IWIN-FINS/FinsROV-Heavy/docs/reference/README.md

# Original reference attachments / 原始参考附件

[Build guide](../README.md) · [制作教程](../README.zh-CN.md)

These files were supplied with the V5 build notes and are retained byte-for-byte. They are reference copies, not newly maintained releases. Third-party software, manuals and embedded notices retain their original ownership and terms; the repository's root license does not relicense them. The executables were not run during documentation preparation.

以下文件随原制作记录提供，按原字节保存。第三方程序及厂商文档适用其原有声明，不因放入本仓库而改为根目录许可证。

| Attachment / 附件 | Use / 用途 |
| --- | --- |
| [BLHeliSuite32 32.10.0.0](BLHeliSuite32_32.10.0.0.zip?raw=true) | 原实装 BLHeli32 调参工具；先核对电调版本 |
| [PCM380 曲线拟合调试软件用户版 V0.1](PCM380曲线拟合调试软件用户版V0.1.rar?raw=true) | 原水压计调参工具；名称不用于改写实装传感器型号 |
| [水压计操作录像](<用户调试软件V0.1 2025-10-29 16-39-50.mp4?raw=true>) | 原记录的调参过程 |
| [达妙 DM-ORIN NX V2.X 说明书 V1.0](<达妙科技DM-ORIN NX V2.X使用说明书V1.0.pdf?raw=true>) | 载板接口和引脚参考；核对实物版本 |

The original interactive PCB BOM is under [hardware/pcb/assembly](../../hardware/pcb/assembly/README.md). The three Jetson script attachments have publication fixes and are under [software/jetson](../../software/jetson/README.md). See [sources and hashes](../SOURCES.md).
