IWIN-FINS/FinsROV-Heavy/hardware/bom/BOM-electronics.csv

物料编号 | 物料名称 | 单舱数量 | 单位 | 准备方式 | 型号、规格与尺寸 | 核对状态 | 采购或加工渠道 | 采购或加工链接 | 下单与装配说明 | CAD 实例名称 | STEP 产品定义 | 依据 | 参考资料链接
EC-01 | 运动控制主板 | 1 | 块 | 成品购买 | DJI RoboMaster 开发板 A 型 | 型号已识别 | DJI 商城 | https://store.dji.com/product/rm-development-board-type-a?from=shop | STM32F427IIH6；与机载计算机经 UART 通信。核所购套件配线及库存。 | ROBOMASTER_A板 v2 | #3176918 | STEP 实例；论文实机平台说明与硬件图 | https://www.robomaster.com/zh-CN/products/components/general/development-board
EC-02 | 机载计算载板 | 1 | 块 | 成品购买 | 达妙 DM Orin NX-CB-V2.1 | 版本待核 | 达妙原厂咨询 | https://www.dmbot.cn/index.php?c=show&id=97 | 按 V2.1 核对接口与孔位。套装如已含 EC-03 或散热件，应从分购清单扣除。 | DM Orin NX-CB-V2.1 v3 | #3177263 | 舱内装配.step 实例名与装配树
EC-03 | 机载计算模组 | 1 | 块 | 成品购买 | NVIDIA Jetson Orin NX；CAD 嵌套于达妙载板 | 容量待核 | NVIDIA 模组渠道 | https://www.nvidia.cn/autonomous-machines/embedded-systems/ | 单机 1 块。8 GB / 16 GB、启动存储配置与散热器供货范围待核；CAD 子树含风扇和散热件。 | JESTON ORIN NX核心板 v2 | #3178250 | STEP 实例；论文实机平台说明与硬件图 | https://www.nvidia.cn/autonomous-machines/embedded-systems/jetson-orin/
EC-04 | 惯性测量单元（IMU） | 1 | 处 | 成品购买 | 论文实机 WHEELTEC H30；CAD 为达妙 DM-IMU-L1 | 实机版本待核 | 淘宝检索论文型号 | https://s.taobao.com/search?q=%E8%BD%AE%E8%B6%A3%20H30%20IMU | 按一个安装位置计。论文图可见 WHEELTEC 字样；暂按实验用 H30 备查。购买前核版本、接口和安装孔。 | 达妙IMU v3 | #3177175 | STEP 实例；论文实机平台说明与硬件图 | https://wiki.seeedstudio.com/cn/wheeltec_imu/
EC-05 | 四合一无刷电调 | 2 | 块 | 成品购买 | 每块 4 路，安装孔距 30.5 mm；BLHeli_32，双向 DShot | 原购型号待核 | 淘宝按参数检索 | https://s.taobao.com/search | 2 块共驱动 8 台推进器。核品牌、额定电流、供电范围和双向转速回传支持；D13 是导入几何名称。 | 四合一电调30.5孔距 v2 | #3176903、#3176905 | STEP 实例；论文实机平台说明与硬件图
EC-06 | 电力线载波通信板（舱端） | 1 | 套 | 成品/板卡待核 | PCB 子装配含 MSE510CE_Rev.G 模块 | 整板料号待核 | 同类舱端模块询价 | https://fdocean.com/public/gjbj-35/162.html | 本行计舱端 1 套，含底板及子模块。原购型号、电源、接线及与岸端的配对方案待确认。 | 电力载波 v1 | #3176925 | STEP 实例；论文实机平台说明与硬件图
EC-07 | 电源保护与配电板 | 1 | 块 | PCB 制板及装联 | 基于 TI LM5069；CAD 板约 80 × 80 × 1.6 mm | R12 装配状态及板版待核 | 嘉立创 PCBA（推荐） | https://www.jlc-smt.com/ | 已附交互 BOM：R12=10kΩ/R0603/C25804，装配标记为真；原文写不焊且已修改，需核 Gerber/工程/HTML 同版。 | 电源板 v1 | #3177189 | 舱内 STEP；原焊接教程与交互 BOM 存在 R12 冲突 | https://github.com/IWIN-FINS/FinsROV-Heavy/blob/main/docs/build/03-power-board.zh-CN.md
EC-08 | 电调对插板（公板） | 1 | 块 | PCB 制板及装联 | 板约 80 × 40 × 1.6 mm；4 个 12P 连接器、8 个 MR30PB | 设计资料待补 | 嘉立创 PCBA（推荐） | https://www.jlc-smt.com/ | U1–U4 为 2.00 mm 间距连接器，CN1–CN8 为三芯电机接口。需板文件、针脚定义及装联资料。 | 电调对插板_公 v1 | #3176855 | 舱内装配.step 实例名与装配树 | https://www.china-amass.com/biao/632.html
EC-09 | 电调对插板（母板） | 1 | 块 | PCB 制板及装联 | 板约 93 × 74.5 × 1.6 mm；4 个 12P 连接器 | 设计资料待补 | 嘉立创 PCBA（推荐） | https://www.jlc-smt.com/ | 与 EC-08 配对。CAD 型号 XDCZ-20F1-12P，需确认插合面方向、针脚定义及制造资料。 | 电调对插板_母 v2 | #3176883 | 舱内装配.step 实例名与装配树
EC-10 | 20 位接线端子排 | 1 | 条 | 成品购买 | H3800-20P；CAD 长约 80 mm | 按极数选型 | 联捷 H3800 系列 | https://www.cnelinker.com/product.php?goods_id=1258&x=y | 按极数、接线方式、安装面及额定电流核完整订货号。 | H3800-20P v1 | #3176916 | 舱内装配.step 实例名与装配树
EC-11 | 18 位接线端子排 | 1 | 条 | 成品购买 | H3800-18P；CAD 长约 73 mm | 按极数选型 | 联捷 H3800 系列 | https://www.cnelinker.com/product.php?goods_id=1258&x=y | 按极数、接线方式、安装面及额定电流核完整订货号。 | H3800-18P v2 | #3178277 | 舱内装配.step 实例名与装配树
IF-01 | 1W 固定式水密插座 | 10 | 只 | 成品购买 | 1W_HVG；壳号与芯数组合待核 | 待选芯数 | LEMO 系列参考 | https://www.lemo.com/int_zh/solutions/supreme/w-underwater.html | 电机端 8、信号端 2，共 10 只。另有本体 EL-02 在电池舱前盖，按两份 CAD 合计 11 只。 核原厂、芯数、键位、额定水深、配插头和锁紧附件。 | 1W_HVG固定式插座 v2 | #3178267 | 舱内装配.step；主体装配.step 设备所在舱盖
IF-02 | 00W 固定式水密插座 | 10 | 只 | 成品购买 | 00W_HVG；壳号与芯数组合待核 | 待选芯数 | LEMO 系列参考 | https://www.lemo.com/int_zh/solutions/supreme/w-underwater.html | 10 只均在信号端。 核原厂、芯数、键位、额定水深、配插头和锁紧附件。 | 00W_HVG固定式插座 v2 | #3178273 | 舱内装配.step；主体装配.step 设备所在舱盖
IF-03 | 水下两段式开关 | 1 | 只 | 成品购买 | ELEC-M10x1XNKG0203；M10 × 1 | 原购型号待核 | 同规格开关参考 | https://sublab.info/communication-control-power/switch | 本件在电子舱信号端。本体 EL-01 在电池舱，按两份 CAD 共 2 只。核实际品牌、触点及线束。 | 水下两段式开关 v2 | #3177182 | 舱内装配.step；主体装配.step 设备所在舱盖
IF-04 | M16 穿线螺丝 | 1 | 件 | 成品选配 | MECH-PB16-1；配 M16 × 1.5 螺母 | 供应商待核 | 淘宝按规格检索 | https://s.taobao.com/search | 与 IF-05 配套。核密封面、线径、耐压与灌封工艺；若成套供货含螺母，一套即可。 | M16穿线螺丝 v1 | #3178268 | 舱内装配.step 实例名与装配树
IF-05 | M16 穿线螺母 | 1 | 个 | 核随件后配购 | M16 × 1.5 | 随件待核 | 淘宝按规格检索 | https://s.taobao.com/search | CAD 单列 1 个。先核 IF-04 装箱清单，再定是否单买。 | M16穿线螺母 v1 | #3178269 | 舱内装配.step 实例名与装配树
IF-06 | 穿线格兰头 | 1 | 套 | 成品选配 | 外螺纹函料装配；CAD 含 2 个子件 | 尺寸待核 | SUBLAB 同类件参考 | https://sublab.info/cables-penetrators-connectors/glandpenetrator | 按整套购买。核实螺纹、线缆外径、护套和耐压要求；与本体 HW-03 盘点时合并。 | 穿线格兰头 v1 | #3178274 | 舱内装配.step 实例名与装配树
IF-07 | 1W 插座固定件 | 1 | 件 | 核随件后配购 | 1W_HVG固定螺丝；CAD 已建模 1 件 | 实际用量待核 | 插座厂家配套询价 | https://www.lemo.com/int_zh/solutions/supreme/w-underwater.html | 模型为薄型锁紧件。数量仅代表可见实例，按各插座实际安装及随附锁紧件核齐，避免按插座数或按此数直接采购。 | 1W_HVG固定螺丝 v2 | #3177187 | 舱内装配.step 实例名与装配树
IF-08 | 00W 插座固定件 | 7 | 件 | 核随件后配购 | 00W_HVG固定螺丝；CAD 已建模 7 件 | 实际用量待核 | 插座厂家配套询价 | https://www.lemo.com/int_zh/solutions/supreme/w-underwater.html | 模型为薄型锁紧件。数量仅代表可见实例，按各插座实际安装及随附锁紧件核齐，避免按插座数或按此数直接采购。 | 00W_HVG固定螺丝 v1 | #3177186、#3177185、#3178265、#3178266、#3178270、#3178271 | 舱内装配.step 实例名与装配树
MTI-01 | 法兰舱内固定环 | 1 | 件 | FDM 3D 打印 | 适配 115 法兰；CAD 轴向跨度约 21 mm | 工艺已确认，耗材待补 | 嘉立创 FDM（推荐） | https://www.jlc-3dp.cn/benefit | 每舱 1 件，单件见制造索引 MTI-01。作者确认 FDM；耗材、打印方向、层高、壁厚、填充及配合待补。 | 法兰仓内固定环 v3 | #3176844 | 作者确认舱内安装件均为 FDM；STEP 实例与单件几何 | https://github.com/IWIN-FINS/FinsROV-Heavy/blob/main/hardware/mechanical/README.zh-CN.md
MTI-02 | 对插板固定件 | 1 | 件 | FDM 3D 打印 | CAD 顶点跨度约 94.6 × 69.9 × 18 mm | 工艺已确认，耗材待补 | 嘉立创 FDM（推荐） | https://www.jlc-3dp.cn/benefit | 每舱 1 件，单件见制造索引 MTI-02。作者确认 FDM；耗材、打印方向、层高、壁厚、填充及配合待补。 | 对插板固定件 | #3176901 | 作者确认舱内安装件均为 FDM；STEP 实例与单件几何 | https://github.com/IWIN-FINS/FinsROV-Heavy/blob/main/hardware/mechanical/README.zh-CN.md
MTI-03 | 主控固定板 | 1 | 件 | FDM 3D 打印 | 底板子件，约 115 × 86 × 5 mm | 工艺已确认，耗材待补 | 嘉立创 FDM（推荐） | https://www.jlc-3dp.cn/benefit | 每舱 1 件，单件见制造索引 MTI-03。作者确认 FDM；耗材、打印方向、层高、壁厚、填充及配合待补。 | 主控固定板 | #3176909 | 作者确认舱内安装件均为 FDM；STEP 实例与单件几何 | https://github.com/IWIN-FINS/FinsROV-Heavy/blob/main/hardware/mechanical/README.zh-CN.md
MTI-04 | 电调固定板 | 1 | 件 | FDM 3D 打印 | 底板子件，约 113 × 86 × 6 mm | 工艺已确认，耗材待补 | 嘉立创 FDM（推荐） | https://www.jlc-3dp.cn/benefit | 每舱 1 件，单件见制造索引 MTI-04。作者确认 FDM；耗材、打印方向、层高、壁厚、填充及配合待补。 | 电调固定板 | #3176910 | 作者确认舱内安装件均为 FDM；STEP 实例与单件几何 | https://github.com/IWIN-FINS/FinsROV-Heavy/blob/main/hardware/mechanical/README.zh-CN.md
MTI-05 | 上板 | 1 | 件 | FDM 3D 打印 | 约 122.7 × 86 × 3 mm | 工艺已确认，耗材待补 | 嘉立创 FDM（推荐） | https://www.jlc-3dp.cn/benefit | 每舱 1 件，单件见制造索引 MTI-05。作者确认 FDM；耗材、打印方向、层高、壁厚、填充及配合待补。 | 上板 | #3177179 | 作者确认舱内安装件均为 FDM；STEP 实例与单件几何 | https://github.com/IWIN-FINS/FinsROV-Heavy/blob/main/hardware/mechanical/README.zh-CN.md
MTI-06 | Orin NX 固定板 | 1 | 件 | FDM 3D 打印 | v2；约 106.8 × 90 × 6 mm | 工艺已确认，耗材待补 | 嘉立创 FDM（推荐） | https://www.jlc-3dp.cn/benefit | 每舱 1 件，单件见制造索引 MTI-06。作者确认 FDM；耗材、打印方向、层高、壁厚、填充及配合待补。 | ORIN NX固定板 v2 | #3178263 | 作者确认舱内安装件均为 FDM；STEP 实例与单件几何 | https://github.com/IWIN-FINS/FinsROV-Heavy/blob/main/hardware/mechanical/README.zh-CN.md
MTI-07 | 电源底板 | 1 | 件 | FDM 3D 打印 | 约 86 × 78 × 8 mm | 工艺已确认，耗材待补 | 嘉立创 FDM（推荐） | https://www.jlc-3dp.cn/benefit | 每舱 1 件，单件见制造索引 MTI-07。作者确认 FDM；耗材、打印方向、层高、壁厚、填充及配合待补。 | 电源底板 | #3178264 | 作者确认舱内安装件均为 FDM；STEP 实例与单件几何 | https://github.com/IWIN-FINS/FinsROV-Heavy/blob/main/hardware/mechanical/README.zh-CN.md
MTI-08 | 定长螺母条 | 4 | 根 | 定长采购 / 加工 | CAD 337 × 6 × 2 mm；单舱四根 | 螺纹规格待核 | 按尺寸检索 | https://s.taobao.com/search | 需材质、孔距、牙规与端部孔中心位置。 | 螺母条_定制长度款 v1 | #3176849 | 舱内装配.step 实例名与装配树
FI-01 | M3 铝柱 45 mm | 6 | 根 | 标准件购买 | M3，长 45 mm；铝 | 按尺寸选型 | 淘宝按规格检索 | https://s.taobao.com/search?q=M3%20%E9%93%9D%E6%9F%B1%2045%20mm%20M3 | 核对端部形式、螺纹有效长度及截面尺寸后选型。 | M3铝柱*45 v2 | #3176845、#3176846、#3176847、#3176848、#3176850、#3176851 | 舱内装配.step 实例名与装配树
FI-02 | M3 单头不锈钢柱 20 mm | 6 | 根 | 标准件购买 | M3 × 20 mm，单头牙 | 按尺寸选型 | 淘宝按规格检索 | https://s.taobao.com/search | 核对端部形式、螺纹有效长度及截面尺寸后选型。 | M3*20单头牙不锈钢柱 v2 | #3176894、#3176895、#3176896、#3176897、#3176898、#3176899 | 舱内装配.step 实例名与装配树
FI-03 | M3 铝柱 20 mm | 4 | 根 | 标准件购买 | M3，长 20 mm；铝 | 按尺寸选型 | 淘宝按规格检索 | https://s.taobao.com/search?q=M3%20%E9%93%9D%E6%9F%B1%2020%20mm%20M3 | 核对端部形式、螺纹有效长度及截面尺寸后选型。 | M3铝柱_20mm v1 | #3176920、#3176921、#3176922、#3176923 | 舱内装配.step 实例名与装配树
FI-04 | M3 单头不锈钢柱 10 mm | 4 | 根 | 标准件购买 | M3 × 10 mm，单头牙 | 按尺寸选型 | 淘宝按规格检索 | https://s.taobao.com/search | 核对端部形式、螺纹有效长度及截面尺寸后选型。 | 单头牙M3*10不锈钢柱 v1 | #3177261 | 舱内装配.step 实例名与装配树
FI-05 | M3 扁平头螺丝 | 8 | 颗 | 标准件购买 | M3 × 5 mm，扁平头 | 按尺寸选型 | 淘宝按规格检索 | https://s.taobao.com/search | 核头径、头厚、槽型和材质，与安装板间隙匹配。 | M3*5扁平头螺丝 v2 | #3176902、#3176911、#3176912、#3176913、#3176914 | 舱内装配.step 实例名与装配树
REF-01 | 亚克力舱管 | 1 | 根 | 本体 BOM 已计 | SUBLAB 14010204-1155；115 × 400 mm | 沿用本体物料 | 本体 BOM · EN-01 | https://shop384160755.taobao.com/ | 单舱数量供装配核对，已包含在本体 BOM 对应行，整机汇总时跳过。 | 115*400亚克力舱体 v1 | #3176854 | 舱内装配.step；主体装配.step 设备所在舱盖
REF-02 | 115 法兰 | 2 | 套 | 本体 BOM 已计 | SUBLAB 14010401-1151；本舱占全机 4 套中的 2 套 | 沿用本体物料 | 本体 BOM · EN-03 | https://shop384160755.taobao.com/ | 单舱数量供装配核对，已包含在本体 BOM 对应行，整机汇总时跳过。 | 115法兰 v2 | #3176853 | 舱内装配.step；主体装配.step 设备所在舱盖
REF-03 | 电机端舱盖 | 1 | 件 | 本体 BOM 已计 | 铝合金 CNC；电机端 | 沿用本体物料 | 本体 BOM · EN-07 | https://www.jlc-cnc.com/ | 单舱数量供装配核对，已包含在本体 BOM 对应行，整机汇总时跳过。 | 舱盖_电机端 | #3177180 | 舱内装配.step；主体装配.step 设备所在舱盖
REF-04 | 信号端舱盖 | 1 | 件 | 本体 BOM 已计 | 铝合金 CNC；信号端 | 沿用本体物料 | 本体 BOM · EN-08 | https://www.jlc-cnc.com/ | 单舱数量供装配核对，已包含在本体 BOM 对应行，整机汇总时跳过。 | 舱盖_信号端 | #3177181 | 舱内装配.step；主体装配.step 设备所在舱盖
MTI-09 | IMU 保护外壳（选装） |  | 套 | FDM 3D 打印 | 遮护 IMU 电路，避免电路外露；模型含两片壳体 | 选装，不计默认数量 | 嘉立创 FDM（推荐） | https://www.jlc-3dp.cn/benefit | 选装时 1 套。核 IMU 型号、外壳安装空间、耗材及打印参数；用于电路遮护，不作为防水耐压壳。 | IMU外壳 v5 |  | 作者确认选装用途、舱内安装件为 FDM；独立模型 | https://github.com/IWIN-FINS/FinsROV-Heavy/blob/main/hardware/mechanical/README.zh-CN.md
