IWIN-FINS/FinsROV-Heavy/hardware/bom/BOM.csv

物料编号 | 物料名称 | 单机数量 | 单位 | 准备方式 | 型号、材料与尺寸 | 下单状态 | 采购渠道或推荐平台 | 采购或加工链接 | 随件说明与待核参数 | CAD 名称 | STEP 定义编号 | 判定依据 | 原厂规格或工艺说明链接
PR-01 | 水下推进器 | 8 | 台 | 成品购买 | HYDROCEAN MOT-P75-170；4 水平 + 4 垂直；4 CW + 4 CCW | 按料号采购 | 大洋智能原厂询价 | https://www.hydrocean.cn/underwater-thruster-p-75.html | 选择 170 版本；按编号图核对桨向与实际转向，确认网罩和线缆端接。 | P75推进器简图 | #159701 | 论文与 STEP；原制作记录确认 4 CW + 4 CCW | https://github.com/IWIN-FINS/FinsROV-Heavy/blob/main/docs/build/04-thrusters.zh-CN.md
EN-01 | 透明亚克力舱管 | 1 | 根 | 成品购买 | SUBLAB 14010204-1155；115 系列，长 400 mm | 按料号采购 | SUBLAB 官方淘宝店 | https://shop384160755.taobao.com/ | 按料号向官方店订购。 | 14010204-1155 | #159705 | CAD 料号与原厂规格一致 | https://sublab.info/enclosures-buoyancy-ballast/EnclosureAcrylicTube
EN-02 | 铝合金舱管 | 1 | 根 | 成品购买 | SUBLAB 14010301-1154；115 系列，长 350 mm | 按料号采购 | SUBLAB 官方淘宝店 | https://shop384160755.taobao.com/ | 按料号向官方店订购。 | 14010301-1154 | #159721 | CAD 料号与原厂规格一致 | https://sublab.info/enclosures-buoyancy-ballast/AlEnclosure
EN-03 | 密封舱法兰套件 | 4 | 套 | 成品购买 | SUBLAB 14010401-1151；115 系列 | 按料号采购 | SUBLAB 官方淘宝店 | https://shop384160755.taobao.com/ | 每套含 1 个端面圈、2 个径向圈。全机随件合计 4 个端面圈、8 个径向圈，已计入这 4 套。 | 14010401-1151 | #159720 | CAD 料号与原厂规格一致 | https://sublab.info/enclosures-buoyancy-ballast/flange
EN-04 | 铝舱安装座（宽款） | 1 | 套 | 成品购买 | SUBLAB 14010601-0046；原厂标称宽 46 mm | 待核安装尺寸 | SUBLAB 官方淘宝店 | https://shop384160755.taobao.com/ | 每套含底座、2 个夹块、2 颗长螺丝。CAD 节点为单实体，轴向跨度 150 mm，订购前核对实物图纸、孔距及有无改件。 已提供单件模型，见制造索引 EN-04。 | 14010601-0046 | #159719 | CAD 料号与原厂规格一致 | https://sublab.info/enclosures-buoyancy-ballast/EnclosurePlate
EN-05 | 电池舱后盖 | 1 | 件 | 铝合金 CNC | 铝合金；CAD 外圆 Ø115 mm，厚 6 mm | 按图询价 | 嘉立创 CNC（推荐） | https://www.jlc-cnc.com/ | 按本件孔图单独报价。补铝材牌号、表处、法兰贴合面粗糙度与公差，核对安装孔及螺纹标注。 已提供单件模型，见制造索引 EN-05。 | 电池舱后盖 | #159722 | 实机作者确认；STEP 实例与几何 | https://github.com/IWIN-FINS/FinsROV-Heavy/blob/main/hardware/mechanical/README.zh-CN.md
EN-06 | 电池舱前盖 | 1 | 件 | 铝合金 CNC | 铝合金；CAD 外圆 Ø115 mm，厚 6 mm | 按图询价 | 嘉立创 CNC（推荐） | https://www.jlc-cnc.com/ | 按本件孔图单独报价。补铝材牌号、表处、法兰贴合面粗糙度与公差，核对安装孔及螺纹标注。 已提供单件模型，见制造索引 EN-06。 | 电池舱前盖 | #159730 | 实机作者确认；STEP 实例与几何 | https://github.com/IWIN-FINS/FinsROV-Heavy/blob/main/hardware/mechanical/README.zh-CN.md
EN-07 | 电机端舱盖 | 1 | 件 | 铝合金 CNC | 铝合金；CAD 外圆 Ø115 mm，厚 6 mm | 按图询价 | 嘉立创 CNC（推荐） | https://www.jlc-cnc.com/ | 按本件孔图单独报价。补铝材牌号、表处、法兰贴合面粗糙度与公差，核对安装孔及螺纹标注。 已提供单件模型，见制造索引 EN-07。 | 舱盖_电机端 | #159773 | 实机作者确认；STEP 实例与几何 | https://github.com/IWIN-FINS/FinsROV-Heavy/blob/main/hardware/mechanical/README.zh-CN.md
EN-08 | 信号端舱盖 | 1 | 件 | 铝合金 CNC | 铝合金；CAD 外圆 Ø115 mm，厚 6 mm | 按图询价 | 嘉立创 CNC（推荐） | https://www.jlc-cnc.com/ | 按本件孔图单独报价。补铝材牌号、表处、法兰贴合面粗糙度与公差，核对安装孔及螺纹标注。 已提供单件模型，见制造索引 EN-08。 | 舱盖_信号端 | #159774 | 实机作者确认；STEP 实例与几何 | https://github.com/IWIN-FINS/FinsROV-Heavy/blob/main/hardware/mechanical/README.zh-CN.md
FR-01 | 机架侧板 A | 1 | 件 | 铝合金钣金 | 铝合金钣金；黑色阳极氧化；700 × 295 × 6 mm | 两侧同件，合计 2 件 | 嘉立创钣金（推荐） | https://www.jlc-bj.com/ | 作者确认两侧相同，统一用侧板V2.step，各行 1 件、合计 2 件。旧总装差异保留追溯；铝材牌号、孔公差及旧图适配待核。 | 侧板-铝合金钣金 | #159702 | 作者确认两侧相同、铝合金钣金及黑色阳极氧化；保留原 STEP 定义追溯 | https://github.com/IWIN-FINS/FinsROV-Heavy/blob/main/hardware/mechanical/README.zh-CN.md
FR-02 | 机架侧板 B | 1 | 件 | 铝合金钣金 | 铝合金钣金；黑色阳极氧化；700 × 295 × 6 mm | 两侧同件，合计 2 件 | 嘉立创钣金（推荐） | https://www.jlc-bj.com/ | 作者确认两侧相同，统一用侧板V2.step，各行 1 件、合计 2 件。旧总装差异保留追溯；铝材牌号、孔公差及旧图适配待核。 | 侧板-铝合金钣金 (1) | #159704 | 作者确认两侧相同、铝合金钣金及黑色阳极氧化；保留原 STEP 定义追溯 | https://github.com/IWIN-FINS/FinsROV-Heavy/blob/main/hardware/mechanical/README.zh-CN.md
FR-03 | 机架顶板 | 1 | 件 | 铝合金钣金 | 铝合金钣金；黑色阳极氧化；成形约 700 × 500 × 30 mm，板厚 6 mm | 已对应模型，图纸待核 | 嘉立创钣金（推荐） | https://www.jlc-bj.com/ | 单件见顶板V2.step。铝材牌号、折弯内 R、成形公差与螺纹待补；旧 PDF 适配待核。 | 顶板-铝合金钣金 | #159703 | 作者确认铝合金钣金、黑色阳极氧化；STEP 几何 | https://github.com/IWIN-FINS/FinsROV-Heavy/blob/main/hardware/mechanical/README.zh-CN.md
FR-04 | 舱体不锈钢光轴 | 4 | 根 | 定长采购 | 实心圆轴 Ø8 × 412 mm，平端，无建模螺纹 | 按尺寸选配 | 嘉立创 FA 定长光轴 | https://www.jlcfa.com/product/B/B08/BACA?series=1 | 选不锈钢、两端无加工；核牌号、外径及长度公差。目录为推荐渠道。 | 舱体不锈钢光轴、舱体不锈钢光轴_1、舱体不锈钢光轴_2、舱体不锈钢光轴_3 | #159706、#159707、#159708、#159709 | STEP 名称与实体几何
FR-05 | 光轴夹 | 6 | 套 | 成品购买 | 适配 Ø8 mm 光轴；CAD 夹宽 10 mm，安装孔 Ø4.5 mm | 待选型 | 淘宝按尺寸检索 | https://s.taobao.com/search | 每套两件按一套采购。比对安装面、孔位和耐蚀材质；原购货号待补。 已附垫片模型供参考，不重复计数。 | 光轴夹、光轴夹_1、光轴夹_2、光轴夹_3、光轴夹_4、光轴夹_5 | #159711、#159712、#159713、#159714、#159715、#159716 | 实机作者确认；STEP 实例与几何 | https://github.com/IWIN-FINS/FinsROV-Heavy/blob/main/hardware/mechanical/README.zh-CN.md
FR-06 | 带螺纹铝合金角码 | 2 | 件 | 成品选配 | 20 × 20 × 10 mm，壁厚 4 mm；模型孔 Ø4 / Ø3.3 mm | 待选型 | 淘宝按尺寸检索 | https://s.taobao.com/search | 制作笔记列 20×20×10 mm、M4 角码 2 件；保留 CAD 孔径。核孔距、安装对应及原购型号。 | 带螺纹铝合金角码、带螺纹铝合金角码_1 | #159727、#159728 | STEP 实例；原制作记录尺寸与数量 | https://github.com/IWIN-FINS/FinsROV-Heavy/blob/main/docs/build/02-frame.zh-CN.md
FR-07 | 机架横梁 | 2 | 件 | 铝合金钣金 | 铝合金钣金；黑色阳极氧化；CAD 长 500 mm、截面外廓 50 × 40 mm；制作笔记板厚 6 mm | 单件与总装版本待核 | 嘉立创钣金（推荐） | https://www.jlc-bj.com/ | 两件钣金、黑色阳极氧化。单件/总装版本差异仍待核；制作笔记框架板厚 6 mm，补牌号、折弯与螺纹。 | 横梁 | #159753 | 作者确认材料、工艺及表面处理；STEP 实例与几何 | https://github.com/IWIN-FINS/FinsROV-Heavy/blob/main/docs/build/02-frame.zh-CN.md
BU-01 | 定制浮力块 | 2 | 件 | 浮力材料定制 | PVC 发泡；密度 0.25 g/cm³（250 kg/m³）；材料耐压深度 250 m；CAD 长 700 mm | 材料参数已确认 | 大洋智能按图加工（推荐） | https://www.hydrocean.cn/subsea-buoyancy-foam.html | 定制 2 件；250 m 仅材料参数。教程预埋孔 Ø6.5 mm、M4×10 螺母共 22 颗（HW-09）；先核外牙/孔配合。净浮力及封装待补。 | 浮力块 | #159763 | 作者确认 PVC 发泡、密度及材料耐压深度；STEP 实例 | https://github.com/IWIN-FINS/FinsROV-Heavy/blob/main/docs/build/02-frame.zh-CN.md
SE-01 | 水压计 | 4 | 只 | 成品购买 | 南京沃天 PCM300Y；实机压力采集总线 RS485 | 待补订货参数 | 南京沃天原厂询价 | https://www.wt-tech.com/products/qssylb5800.html | 两个支架组各装 2 只。向原厂核量程、压力基准、供电、信号输出及是否另需 RS485 转换、线长和出线方式。 | PCM300Y | #159739 | 论文实机平台说明；STEP 实例；CAD 标注 PCM300Y
SE-02 | 水下双目相机 | 1 | 台 | 成品购买 | SUBLAB 11020201-0001；USB 2.0 / UVC | 按料号采购 | SUBLAB 官方淘宝店 | https://shop384160755.taobao.com/ | 固定相机台内 1 台；原厂套装含 USB 测试接口。 | 11020201-0001 | #159766 | CAD 料号与原厂规格一致 | https://sublab.info/sensor-cameras/binocularcam
SE-03 | 水下照明灯 | 3 | 盏 | 成品购买 | CAD 灯头外圆 Ø30 mm，轴向跨度约 132 mm | 待选型 | SUBLAB 官方店（候选） | https://shop384160755.taobao.com/ | 原购型号暂缺。可询 SUBLAB 10030201-0001，确认夹持段外径、总长、供电、调光和出线后再订。 | 照明灯官网图、照明灯官网图_1 | #159738、#159767 | 两 CAD 定义几何相符；2 盏位于灯/水压计支架，1 盏位于相机台 | https://sublab.info/thrusters-actuators-lights/slight
MT-01 | 水压计固定块 A | 1 | 件 | FDM 3D 打印 | A 组仅装水压计 | 按图询价 | 嘉立创 FDM（推荐） | https://m-3dp.jlc.com/placeOrder | 按对应 CAD 实体打印。待补耗材牌号与打印参数，试装核对夹持配合。 已提供单件模型，见制造索引 MT-01。 | 二合一固定块(镜像) (1) | #159733 | 实机作者确认；STEP 实例与几何 | https://www.jlc-3dp.cn/benefit
MT-02 | 水压计固定块 A 镜像件 | 1 | 件 | FDM 3D 打印 | A 组仅装水压计 | 按图询价 | 嘉立创 FDM（推荐） | https://m-3dp.jlc.com/placeOrder | 按对应 CAD 实体打印。待补耗材牌号与打印参数，试装核对夹持配合。 已提供单件模型，见制造索引 MT-02。 | 二合一固定块(镜像) (1)(镜像) | #159734 | 实机作者确认；STEP 实例与几何 | https://www.jlc-3dp.cn/benefit
MT-03 | 灯与水压计固定块 B | 1 | 件 | FDM 3D 打印 | B 组安装灯与水压计 | 按图询价 | 嘉立创 FDM（推荐） | https://m-3dp.jlc.com/placeOrder | 按对应 CAD 实体打印。待补耗材牌号与打印参数，试装核对夹持配合。 已提供单件模型，见制造索引 MT-03。 | 二合一固定块 | #159736 | 实机作者确认；STEP 实例与几何 | https://www.jlc-3dp.cn/benefit
MT-04 | 灯与水压计固定块 B 镜像件 | 1 | 件 | FDM 3D 打印 | B 组安装灯与水压计 | 按图询价 | 嘉立创 FDM（推荐） | https://m-3dp.jlc.com/placeOrder | 按对应 CAD 实体打印。待补耗材牌号与打印参数，试装核对夹持配合。 已提供单件模型，见制造索引 MT-04。 | 二合一固定块(镜像) | #159737 | 实机作者确认；STEP 实例与几何 | https://www.jlc-3dp.cn/benefit
MT-05 | 相机台主体支架 | 1 | 件 | FDM 3D 打印 | 相机云台 v15 内，长向跨度 162 mm | 按图询价 | 嘉立创 FDM（推荐） | https://m-3dp.jlc.com/placeOrder | 已提供单件模型，见制造索引 MT-05。 打印材料、方向、壁厚与螺纹处理待核。 | 零部件16 | #159770 | 实机作者确认；STEP 实例与几何；部位按父装配识别 | https://www.jlc-3dp.cn/benefit
MT-06 | 相机台固定座 | 1 | 件 | FDM 3D 打印 | 固定相机台下的独立零件，外廓约 80 × 35 × 40 mm | 按图询价 | 嘉立创 FDM（推荐） | https://m-3dp.jlc.com/placeOrder | 已提供单件模型，见制造索引 MT-06。 打印材料、方向、壁厚与螺纹处理待核。 | 零部件25 | #159771 | 实机作者确认；STEP 实例与几何；部位按父装配识别 | https://www.jlc-3dp.cn/benefit
MT-07 | 相机台内薄环板 | 1 | 件 | 工艺待核 | 厚 2 mm，中央圆孔 Ø26 mm；位于相机云台 v15 | 待核工艺 | 嘉立创按图评估（备选） | https://www.jlc-bj.com/ | 作者确认相机支架整体采用 FDM；该薄环板的用途、是否随设备配套及制法仍待确认。 | 零部件2_3 | #159768 | STEP 名称与实体几何
EL-01 | M10 舱壁电气件 | 1 | 套 | 成品购买 | CAD 标识 ELEC-M10x1XNKG0203；M10 × 1 | 待核身份 | SUBLAB 同类件咨询（候选） | https://sublab.info/communication-control-power/switch | 外形及代号提示可能为旋钮开关。核对实物功能、档位、走线与原厂料号后再订；按两子件组成的一套计。 | ELEC-M10x1XNKG0203 | #159724 | STEP 名称与实体几何
EL-02 | 1W 系列固定式插座 | 1 | 只 | 成品购买 | CAD 标识 1W_HVG；轴向长 30 mm | 待选型 | LEMO W 系列询价（候选） | https://www.lemo.com/int_zh/solutions/supreme/w-underwater.html | HVG.1W 为候选系列。实机品牌、芯数、键位、尾端形式、配插端货号及耐压等级待核。 | 1W_HVG固定式插座 | #159772 | STEP 名称与实体几何
CB-01 | 电机线夹压片 | 2 | 件 | 工艺待核 | 41 × 15 × 2 mm，2 个 Ø3.3 mm 孔 | 待核工艺 | 嘉立创钣金（备选） | https://www.jlc-bj.com/ | 实机材料及制法暂缺。若为金属压片，核板材、孔距与表处后询价。 已提供单件模型，见制造索引 CB-01。 | 零部件4 | #159742 | STEP 名称与实体几何 | https://github.com/IWIN-FINS/FinsROV-Heavy/blob/main/hardware/mechanical/README.zh-CN.md
CB-02 | 电机线夹压片（镜像） | 2 | 件 | 工艺待核 | 41 × 15 × 2 mm，2 个 Ø3.3 mm 孔 | 待核工艺 | 嘉立创钣金（备选） | https://www.jlc-bj.com/ | 实机材料及制法暂缺。若为金属压片，核板材、孔距与表处后询价。 已提供单件模型，见制造索引 CB-02。 | 零部件4(镜像) | #159745 | STEP 名称与实体几何 | https://github.com/IWIN-FINS/FinsROV-Heavy/blob/main/hardware/mechanical/README.zh-CN.md
CB-03 | 电机线夹夹体 | 2 | 件 | 3D 打印（具体工艺待核） | 夹体厚 15 mm，多槽 | 模型与数量口径待核 | 嘉立创 FDM（备选） | https://m-3dp.jlc.com/placeOrder | 教程写每台电机 1 夹、共 8 个；本行保留 STEP 数量，与 CB-04/CB-03 夹体合计 4 件。模型及压板对应、打印工艺/耗材待核。 | 零部件3 | #159743 | STEP 实例；原制作记录写 3D 打印 8 个，尚未完成模型对应 | https://github.com/IWIN-FINS/FinsROV-Heavy/blob/main/docs/build/02-frame.zh-CN.md
CB-04 | 电机线夹夹体（镜像） | 2 | 件 | 3D 打印（具体工艺待核） | 夹体厚 15 mm，多槽 | 模型与数量口径待核 | 嘉立创 FDM（备选） | https://m-3dp.jlc.com/placeOrder | 教程写每台电机 1 夹、共 8 个；本行保留 STEP 数量，与 CB-04/CB-03 夹体合计 4 件。模型及压板对应、打印工艺/耗材待核。 | 零部件3(镜像) | #159744 | STEP 实例；原制作记录写 3D 打印 8 个，尚未完成模型对应 | https://github.com/IWIN-FINS/FinsROV-Heavy/blob/main/docs/build/02-frame.zh-CN.md
CB-05 | 普通线夹 | 6 | 件 | 工艺待核 | 夹宽 10 mm，槽半径 3.5 mm，安装孔 Ø3.3 mm | 待核工艺 | 嘉立创 FDM（备选） | https://m-3dp.jlc.com/placeOrder | 实机材料及制法暂缺。可询 FDM 打样，先校核持线槽、夹紧力和固定孔。 已提供单件模型，见制造索引 CB-05。 | 零部件1_4 | #159752 | STEP 名称与实体几何 | https://github.com/IWIN-FINS/FinsROV-Heavy/blob/main/hardware/mechanical/README.zh-CN.md
CB-06 | 云台线缆夹 1 号夹体 | 1 | 件 | 工艺待核 | 夹体厚 15 mm，按 1 号夹槽图 | 待核工艺 | 嘉立创 FDM（备选） | https://m-3dp.jlc.com/placeOrder | 实机材料及制法暂缺。可询 FDM 打样，先校核持线槽、夹紧力和固定孔。 已提供单件模型，见制造索引 CB-06。 | 零部件2_2 | #159756 | STEP 名称与实体几何 | https://github.com/IWIN-FINS/FinsROV-Heavy/blob/main/hardware/mechanical/README.zh-CN.md
CB-07 | 云台线缆夹 1 号压片 | 1 | 件 | 工艺待核 | 41 × 15 × 2 mm，按 1 号压片图 | 待核工艺 | 嘉立创钣金（备选） | https://www.jlc-bj.com/ | 实机材料及制法暂缺。若为金属压片，核板材、孔距与表处后询价。 已提供单件模型，见制造索引 CB-07。 | 零部件3_1 | #159757 | STEP 名称与实体几何 | https://github.com/IWIN-FINS/FinsROV-Heavy/blob/main/hardware/mechanical/README.zh-CN.md
CB-08 | 云台线缆夹 2 号夹体 | 1 | 件 | 工艺待核 | 夹体厚 15 mm，按 2 号夹槽图 | 待核工艺 | 嘉立创 FDM（备选） | https://m-3dp.jlc.com/placeOrder | 实机材料及制法暂缺。可询 FDM 打样，先校核持线槽、夹紧力和固定孔。 已提供单件模型，见制造索引 CB-08。 | 零部件3_2 | #159761 | STEP 名称与实体几何 | https://github.com/IWIN-FINS/FinsROV-Heavy/blob/main/hardware/mechanical/README.zh-CN.md
CB-09 | 云台线缆夹 2 号压片 | 1 | 件 | 工艺待核 | 41 × 15 × 2 mm，按 2 号压片图 | 待核工艺 | 嘉立创钣金（备选） | https://www.jlc-bj.com/ | 实机材料及制法暂缺。若为金属压片，核板材、孔距与表处后询价。 已提供单件模型，见制造索引 CB-09。 | 零部件4_1 | #159762 | STEP 名称与实体几何 | https://github.com/IWIN-FINS/FinsROV-Heavy/blob/main/hardware/mechanical/README.zh-CN.md
CK-01 | 顶层空节点 |  |  | 待核占位 | 顶层定位点约 (2, −47.47, 2) mm；仅坐标系 | 待核身份 |  |  | 模型有 1 个定位实例。核实装配历史或照片后决定是否对应实物，单机物料数量留空。 | 零部件18 | #159723 | STEP 引用 #474，无实体和子件
HW-01 | 其余机架及外装设备紧固件 |  | 颗 | 另购标准件 | 推进器安装界面 4 × M3/台；其他位置按装配孔图 | 待统计 | 嘉立创 FA 紧固件选型 | https://www.jlcfa.com/serial/2129403909149.html?codeModel=EDLA-S2 | 不含已单列的 HW-06～HW-09。其余按实装统计并扣除套件随件；配重 M4 螺钉长度、螺母/垫圈及数量待核。 |  |  | 原厂 P75 接口；STEP 未单列紧固件 | https://www.hydrocean.cn/underwater-thruster-p-75.html
HW-02 | 舱盖与法兰安装螺钉 |  | 颗 | 另购标准件 | 四处盖板分别对照法兰端面孔及盖板孔图 | 待统计 | 嘉立创 FA 紧固件选型 | https://www.jlcfa.com/serial/2129403909149.html?codeModel=EDLA-S2 | 与机架紧固件分开计。核螺纹、头型、有效旋入长度及实装数量；法兰随件密封圈已计入 EN-03。 |  |  | STEP 装配界面；SUBLAB 法兰装箱清单 | https://sublab.info/enclosures-buoyancy-ballast/flange
HW-03 | 穿舱密封件及线缆格兰头 |  | 件 | 按接口配购 | 按实际出线逐路匹配线径、安装孔和舱盖厚度 | 待统计 | SUBLAB 官方淘宝店 | https://shop384160755.taobao.com/ | 盘点推进器、灯、相机和水压计的端接。扣除已随设备供货的接头；示例 M10 格兰头需核插孔及耐压等级。 |  |  | 设备裸线版本与舱盖孔图；STEP 未给全套端接 | https://sublab.info/cables-penetrators-connectors/copperglandpenetrator
HW-04 | 未用穿舱孔堵头 |  | 件 | 按接口配购 | 按实装后剩余孔的牙型、孔径和密封方式选型 | 待统计 | SUBLAB 官方淘宝店 | https://shop384160755.taobao.com/ | 扣除已有设备占用孔及套件随件。按实际空孔数选购并核随附密封圈。 |  |  | 原厂堵头选型资料；实装孔位待核 | https://sublab.info/cables-penetrators-connectors/BlankPenetrators
HW-05 | 水密插座配插端及尾附件 |  | 套 | 按接口配购 | 对应 EL-02 的线缆端插头及所需尾附件 | 待统计 | LEMO W 系列询价（候选） | https://www.lemo.com/int_zh/solutions/supreme/w-underwater.html | 确认 EL-02 的厂家、芯数、键位、线缆外径及实机是否已有成缆，再订配插端。 |  |  | STEP 仅有固定式插座节点
BU-02 | 配平铅块 |  | 块 | 成品购买 | 200 g/块；经验用量 4–5 块，总质量约 0.8–1.0 kg | 按需购买 | 淘宝：作者提供商品 | https://item.taobao.com/item.htm?id=561262404205 | 未配重时浮力大于重力。经验 4–5 块；按实际载荷水中配平增减。M4 紧固件计入 HW-01，垫片见 BU-03。 |  |  | 作者提供购买链接、用途与经验用量；未计入基准 STEP | https://e.tb.cn/h.jRkXFiwiurdhOld?tk=7QlA6d6JviR
BU-03 | 铅块孔径适配垫片 |  | 件 | 定制件，工艺待核 | 缩减铅块孔径，适配 M4 安装螺钉 | 按配重配置 | 加工方式待核 |  | 数量随铅块孔数与安装方案确定。材质、制法及配合公差待补；STEP 与 F3D 均已提供。 | 铅块垫片 |  | 作者确认用途；独立模型，未计入基准 STEP | https://github.com/IWIN-FINS/FinsROV-Heavy/blob/main/hardware/mechanical/README.zh-CN.md
MT-08 | 电池固定环 |  | 件 | FDM 3D 打印 | 电池支撑件，防止电池晃动和旋转 | 数量待核 | 嘉立创 FDM（推荐） | https://www.jlc-3dp.cn/benefit | 随实际电池外形配置，与定位片配合。材料、打印参数、数量及装配位置待补。 | 电池固定环 |  | 作者确认电池支撑为 3D 打印、舱内安装件为 FDM；独立模型 | https://github.com/IWIN-FINS/FinsROV-Heavy/blob/main/hardware/mechanical/README.zh-CN.md
MT-09 | 电池定位片 |  | 件 | FDM 3D 打印 | 电池支撑件，防止电池晃动和旋转 | 数量待核 | 嘉立创 FDM（推荐） | https://www.jlc-3dp.cn/benefit | 随实际电池外形配置，与固定环配合。材料、打印参数、数量及装配位置待补。 | 电池定位片 |  | 作者确认电池支撑为 3D 打印、舱内安装件为 FDM；独立模型 | https://github.com/IWIN-FINS/FinsROV-Heavy/blob/main/hardware/mechanical/README.zh-CN.md
MT-10 | 电池舱法兰填充件 |  | 件 | FDM 3D 打印 | 电池舱内部填充件；安装关系待核 | 数量及装配待核 | 嘉立创 FDM（推荐） | https://www.jlc-3dp.cn/benefit | 按舱内安装件 FDM 归类。与电池支撑的具体装配关系、实装数量及打印参数待补。 | 电池舱法兰填充 |  | 作者确认舱内安装件为 FDM；独立模型，具体装配关系待核 | https://github.com/IWIN-FINS/FinsROV-Heavy/blob/main/hardware/mechanical/README.zh-CN.md
CB-10 | 光轴短套管 |  | 件 | 工艺待核 | 用于限制线缆夹沿光轴平移 | 数量及制法待核 | 待核 |  | 按线夹位置配置；短/长套管数量、材质、制法及轴向间隙待补。 | 光轴短套管 |  | 作者确认限位用途；独立模型，未计入基准 STEP | https://github.com/IWIN-FINS/FinsROV-Heavy/blob/main/hardware/mechanical/README.zh-CN.md
CB-11 | 光轴长套管 |  | 件 | 工艺待核 | 用于限制线缆夹沿光轴平移 | 数量及制法待核 | 待核 |  | 按线夹位置配置；短/长套管数量、材质、制法及轴向间隙待补。 | 光轴长套管 |  | 作者确认限位用途；独立模型，未计入基准 STEP | https://github.com/IWIN-FINS/FinsROV-Heavy/blob/main/hardware/mechanical/README.zh-CN.md
HW-06 | 框架连接螺钉 | 42 | 颗 | 成品购买 | M4×12；不锈钢；内六角杯头 | 规格已知，原购型号待补 | 淘宝规格检索（非实购店） | https://s.taobao.com/search?q=M4x12%20%E6%9D%AF%E5%A4%B4 | 横梁 16 + 顶板 26 = 42 颗。旧版一孔偏小，先核最终孔/螺纹。数量为安装用量，采购扣除随件。 |  |  | 原制作记录：主体框架搭建；非 STEP 新增实例 | https://github.com/IWIN-FINS/FinsROV-Heavy/blob/main/docs/build/02-frame.zh-CN.md
HW-07 | 电池滑座安装沉头螺钉 | 10 | 颗 | 成品购买 | M3×10；不锈钢；沉头 | 规格已知，原购型号待补 | 淘宝规格检索（非实购店） | https://s.taobao.com/search?q=M3x10%20%E6%B2%89%E5%A4%B4 | 原教程滑座/角码安装步骤用量；采购前核实际孔位、沉头角度和随件，避免重复计数。 |  |  | 原制作记录：主体框架搭建；非 STEP 新增实例 | https://github.com/IWIN-FINS/FinsROV-Heavy/blob/main/docs/build/02-frame.zh-CN.md
HW-08 | 电池限位角码安装螺钉 | 2 | 颗 | 成品购买 | M4×10；不锈钢；内六角杯头 | 规格已知，原购型号待补 | 淘宝规格检索（非实购店） | https://s.taobao.com/search?q=M4x10%20%E6%9D%AF%E5%A4%B4 | 原教程滑座/角码步骤用量；角码最终定位照片待补，采购扣除随件。 |  |  | 原制作记录：主体框架搭建；非 STEP 新增实例 | https://github.com/IWIN-FINS/FinsROV-Heavy/blob/main/docs/build/02-frame.zh-CN.md
HW-09 | 浮力块预埋螺母 | 22 | 颗 | 成品购买 | M4×10；不锈钢；内外牙沉头 | 规格已知，原购型号待补 | 淘宝规格检索（非实购店） | https://s.taobao.com/search?q=M4x10%20%E9%A2%84%E5%9F%8B%E8%9E%BA%E6%AF%8D | 两块浮力块合计 22 颗；原记录安装孔 Ø6.5 mm，核所购外牙尺寸；端面低于浮力块接触面。 |  |  | 原制作记录：主体框架搭建；非 STEP 新增实例 | https://github.com/IWIN-FINS/FinsROV-Heavy/blob/main/docs/build/02-frame.zh-CN.md
