IWIN-FINS/FinsROV-Heavy/hardware/mechanical/source/框架/顶板.step

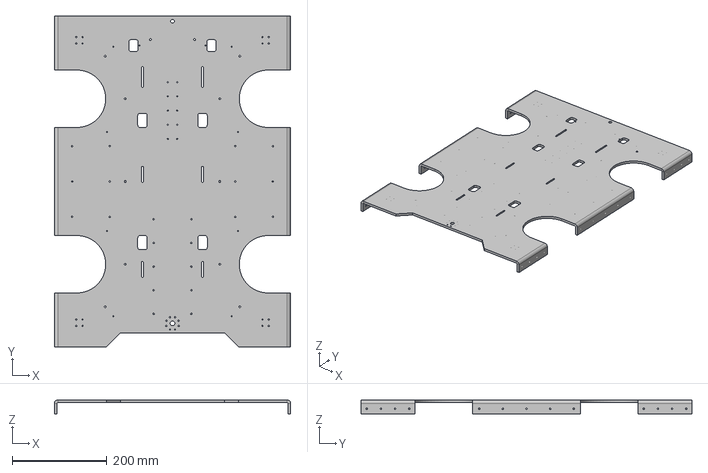
[picture p7: CAD file, 2026-11-11]
hardware/mechanical/source/框架/顶板.step
500.0 x 700.0 x 30.0 mm
