IWIN-FINS/FinsROV-Heavy/hardware/mechanical/source/框架V2/阿卡插座V2.step

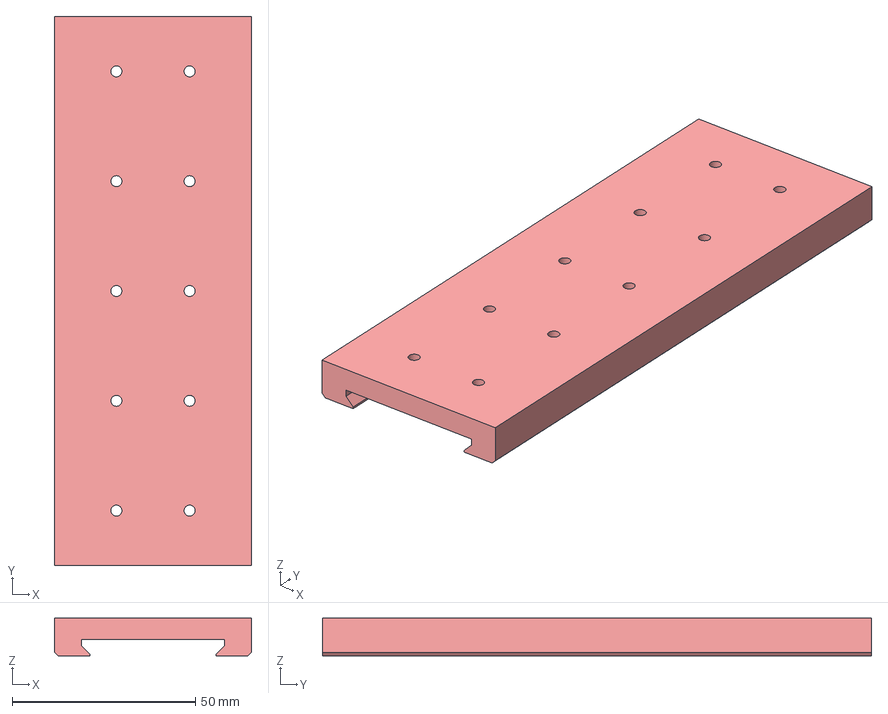
[picture p8: CAD file, 2026-11-11]
hardware/mechanical/source/框架V2/阿卡插座V2.step
53.9 x 150.0 x 10.3 mm
