IWIN-FINS/FinsROV-Heavy/hardware/mechanical/source/电池舱/电池固定环.step

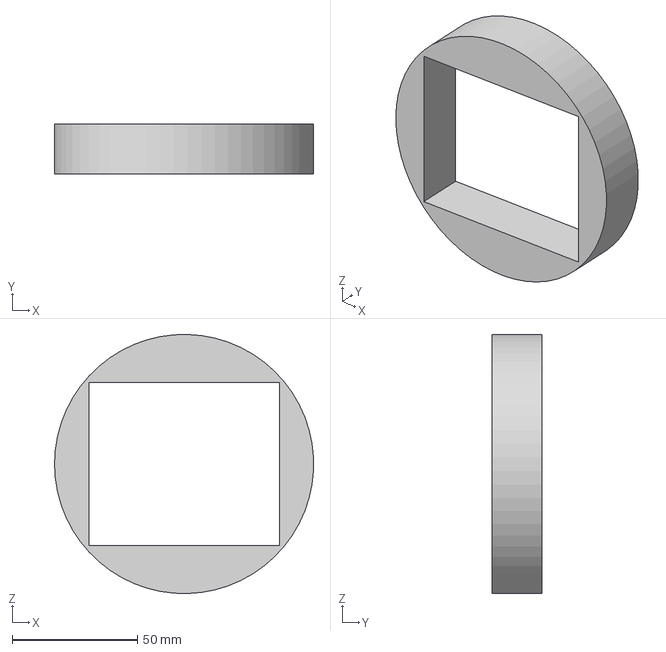
[picture p9: CAD file, 2026-11-11]
hardware/mechanical/source/电池舱/电池固定环.step
103.4 x 20.0 x 103.5 mm
