IWIN-FINS/FinsROV-Heavy/hardware/mechanical/source/盖子.step

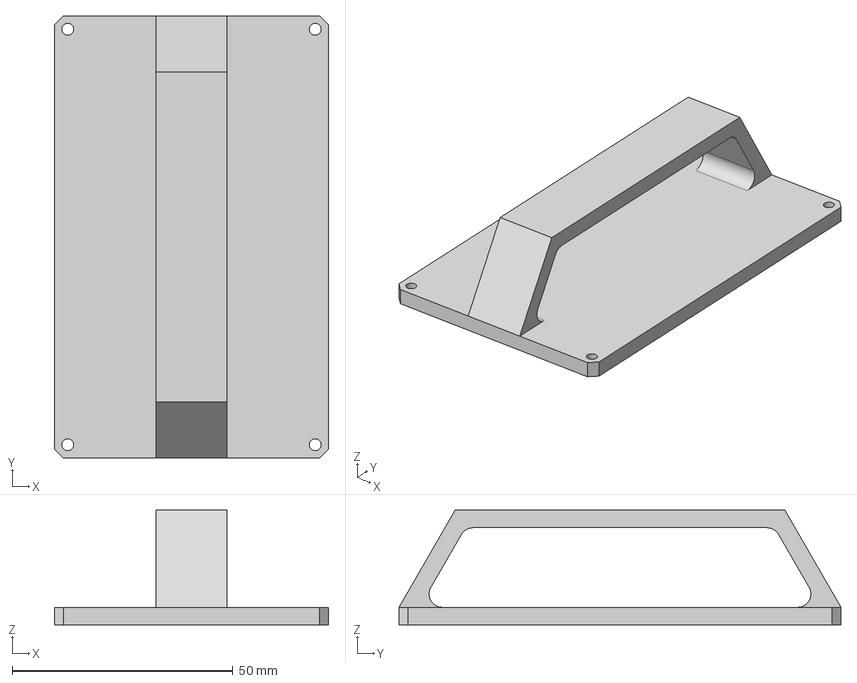
[picture p10: CAD file, 2026-11-11]
hardware/mechanical/source/盖子.step
62.0 x 100.0 x 26.0 mm
