IWIN-FINS/FinsROV-Heavy/hardware/mechanical/source/线缆夹/3pin细线缆管.step

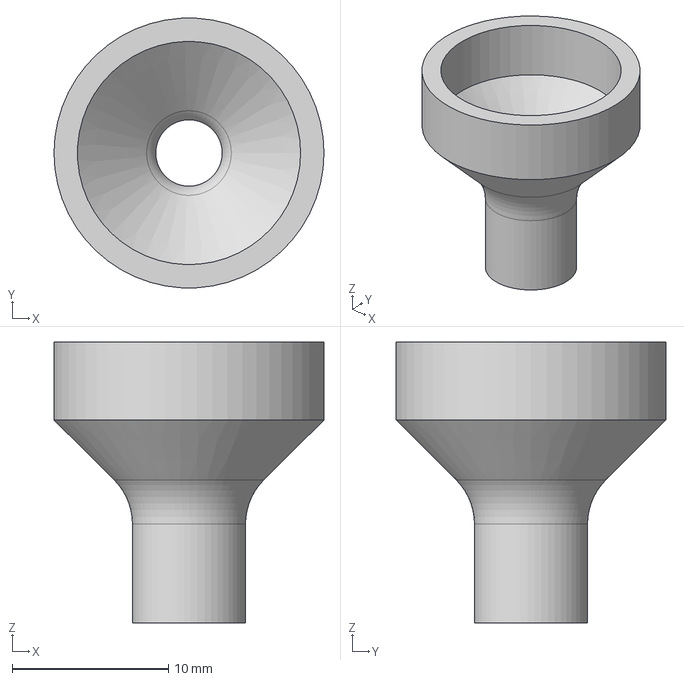
[picture p11: CAD file, 2026-11-11]
hardware/mechanical/source/线缆夹/3pin细线缆管.step
17.3 x 17.3 x 18.0 mm
