IWIN-FINS/FinsROV-Heavy/hardware/mechanical/source/设备舱/舱内/3mf格式/电源底板.3mf

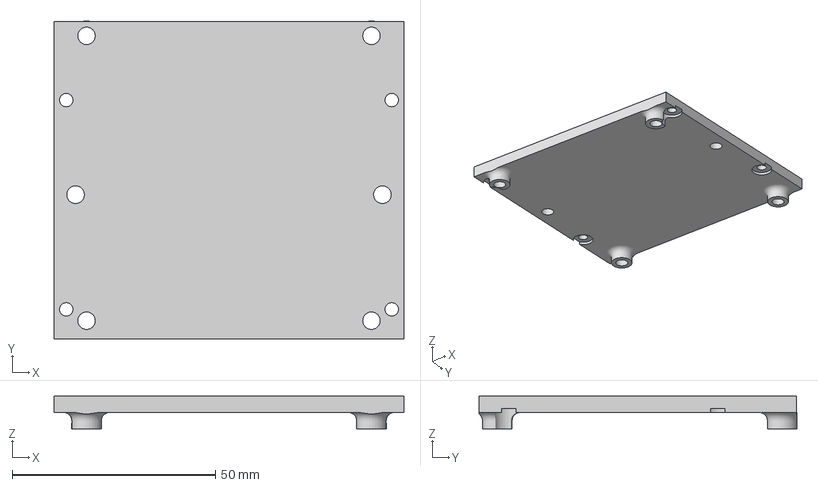
[picture p12: CAD file, 2026-11-11]
hardware/mechanical/source/设备舱/舱内/3mf格式/电源底板.3mf
86.0 x 78.2 x 8.00 mm
