IWIN-FINS/FinsROV-Heavy/hardware/mechanical/source/设备舱/舱内/ORIN NX固定板.step

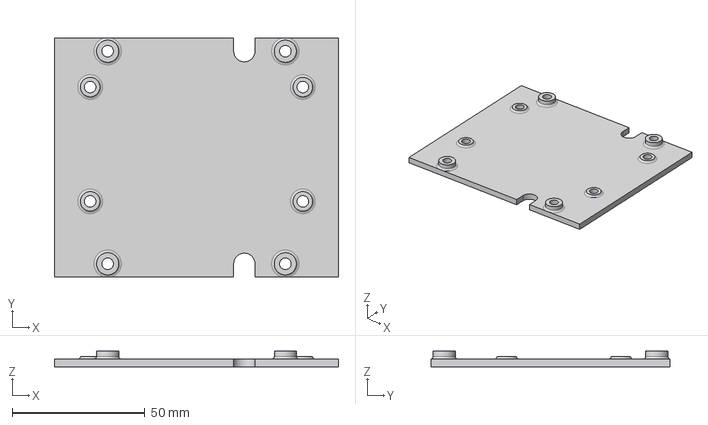
[picture p13: CAD file, 2026-11-11]
hardware/mechanical/source/设备舱/舱内/ORIN NX固定板.step
106.8 x 90.0 x 6.00 mm
