IWIN-FINS/FinsROV-Heavy/hardware/mechanical/source/设备舱/舱盖_信号端.step

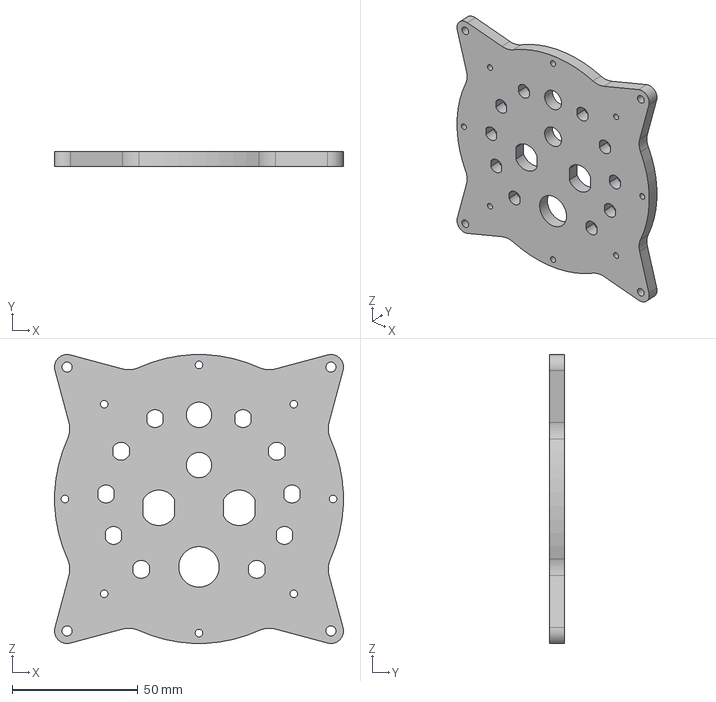
[picture p14: CAD file, 2026-11-11]
hardware/mechanical/source/设备舱/舱盖_信号端.step
115.0 x 6.00 x 115.0 mm
