IWIN-FINS/FinsROV-Heavy/hardware/mechanical/source/固定相机底座.step

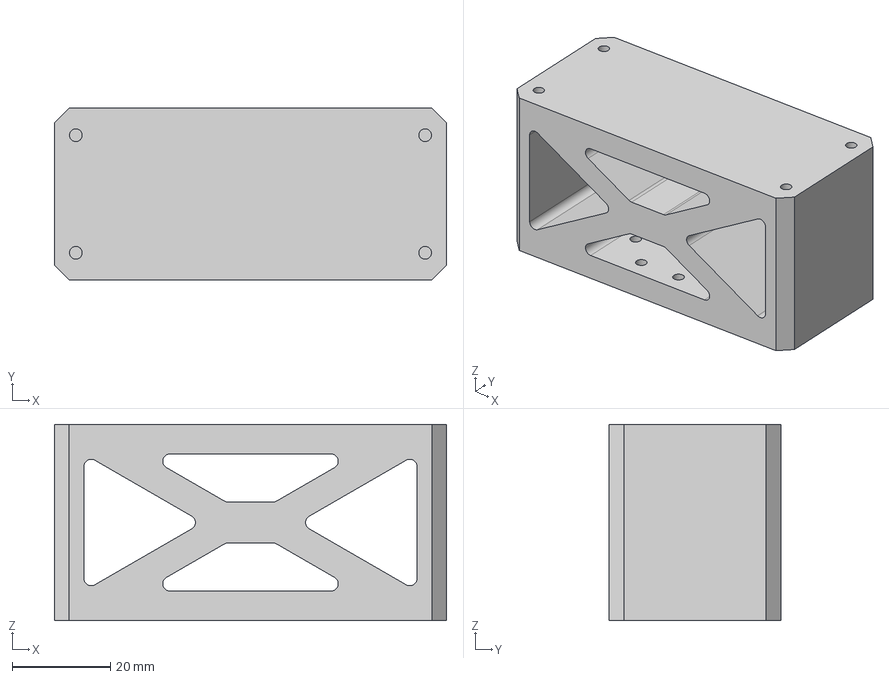
[picture p15: CAD file, 2026-11-11]
hardware/mechanical/source/固定相机底座.step
80.0 x 35.0 x 40.0 mm
