IWIN-FINS/FinsROV-Heavy/hardware/mechanical/source/框架/电机线夹2pin.step

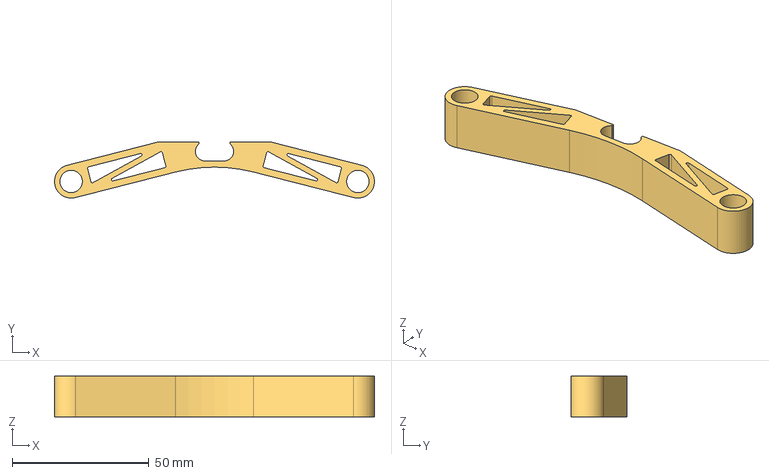
[picture p16: CAD file, 2026-11-11]
hardware/mechanical/source/框架/电机线夹2pin.step
117.2 x 20.6 x 15.0 mm
