IWIN-FINS/FinsROV-Heavy/hardware/mechanical/source/框架V2/浮力块V2.step

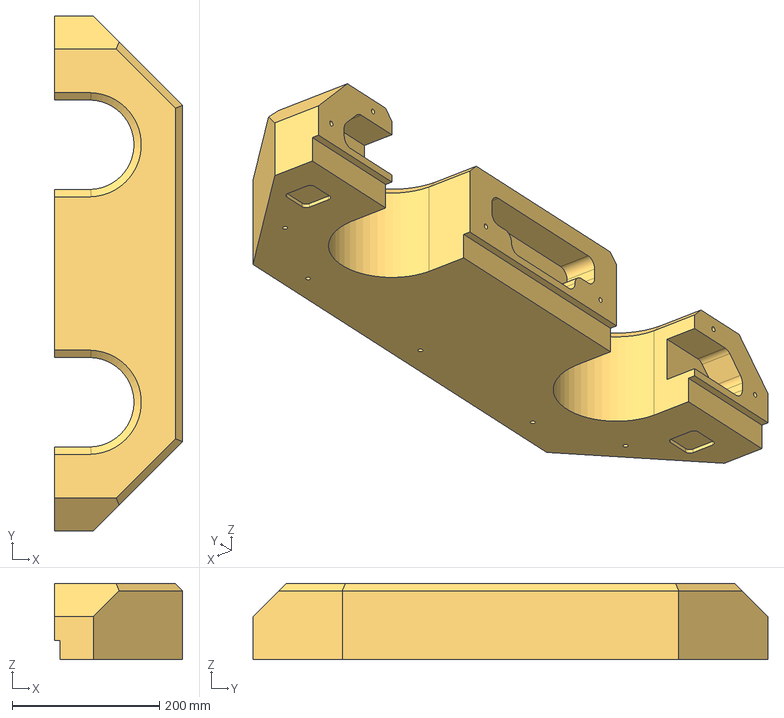
[picture p17: CAD file, 2026-11-11]
hardware/mechanical/source/框架V2/浮力块V2.step
174.5 x 700.0 x 103.4 mm
