IWIN-FINS/FinsROV-Heavy/hardware/mechanical/source/电池舱/电池舱法兰填充.step

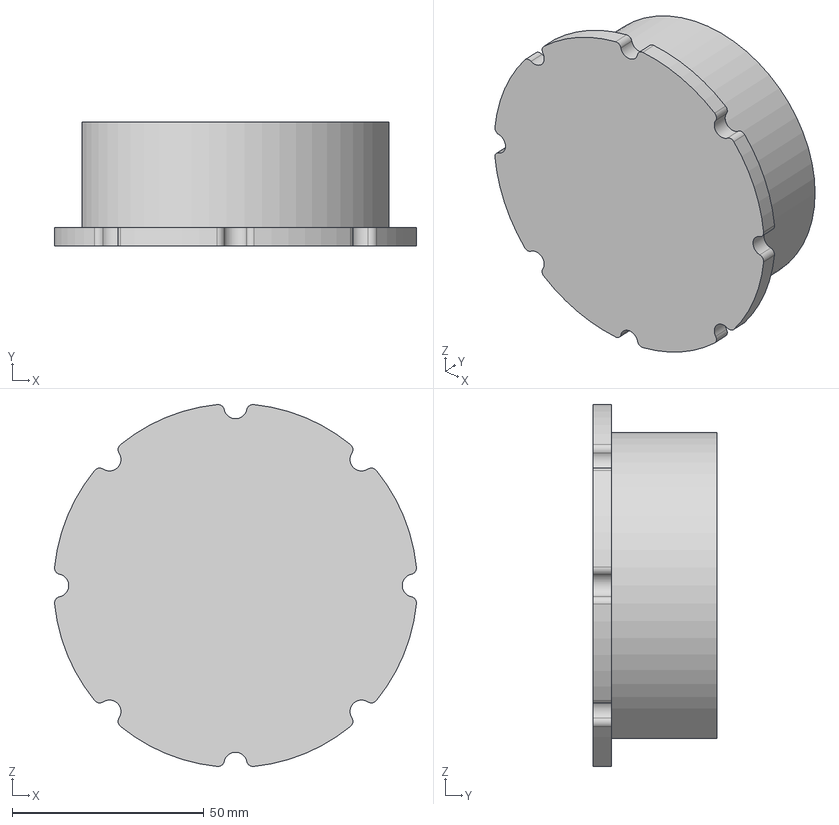
[picture p18: CAD file, 2026-11-11]
hardware/mechanical/source/电池舱/电池舱法兰填充.step
94.4 x 32.4 x 94.4 mm
