IWIN-FINS/FinsROV-Heavy/hardware/mechanical/source/线缆夹/夹片.step

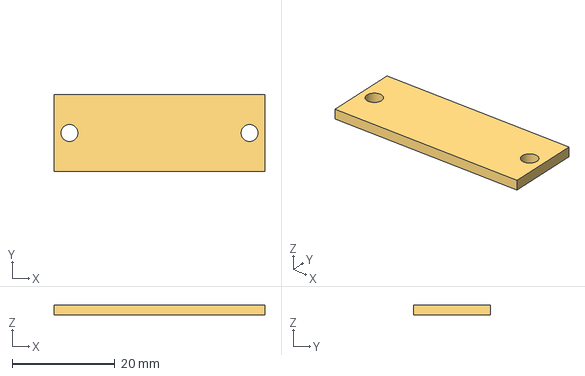
[picture p19: CAD file, 2026-11-11]
hardware/mechanical/source/线缆夹/夹片.step
41.0 x 15.0 x 2.00 mm
