IWIN-FINS/FinsROV-Heavy/hardware/mechanical/source/设备舱/舱内/法兰仓内固定环 v3.step

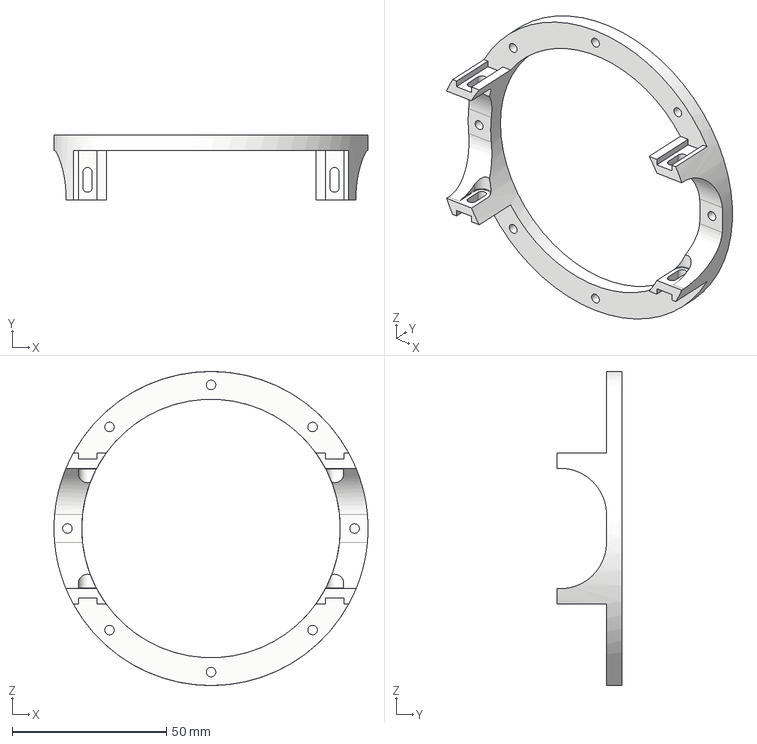
[picture p20: CAD file, 2026-11-11]
hardware/mechanical/source/设备舱/舱内/法兰仓内固定环 v3.step
101.7 x 21.0 x 101.7 mm
