IWIN-FINS/FinsROV-Heavy/hardware/mechanical/source/框架/二合一固定块R.step

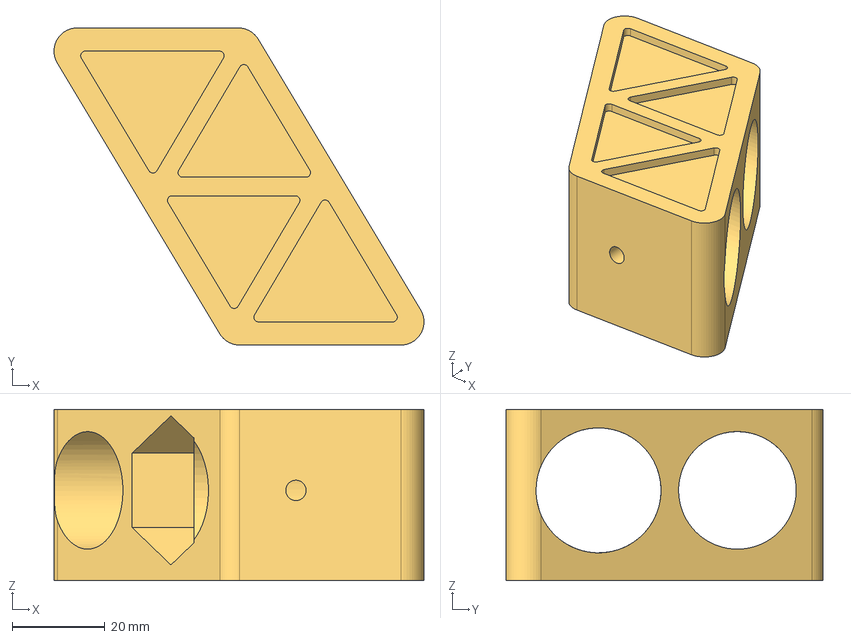
[picture p22: CAD file, 2026-11-11]
hardware/mechanical/source/框架/二合一固定块R.step
79.9 x 68.5 x 37.0 mm
