IWIN-FINS/FinsROV-Heavy/hardware/mechanical/source/电池舱/电池定位片.step

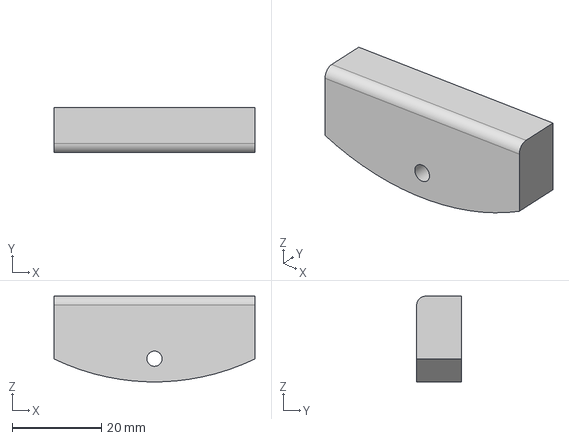
[picture p23: CAD file, 2026-11-11]
hardware/mechanical/source/电池舱/电池定位片.step
45.0 x 10.0 x 19.2 mm
