IWIN-FINS/FinsROV-Heavy/hardware/mechanical/source/盒子.step

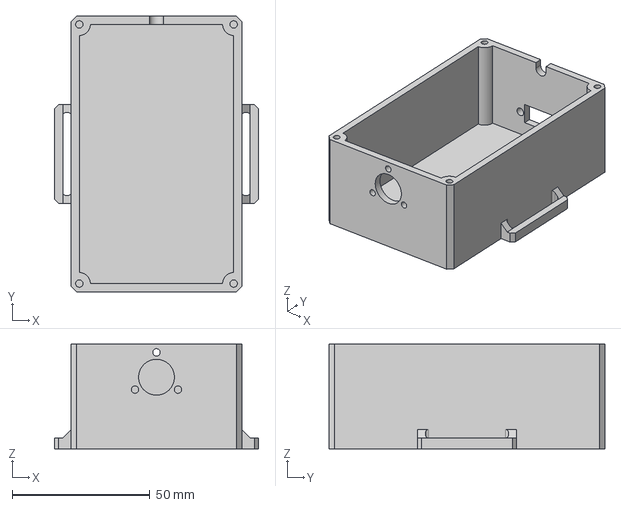
[picture p24: CAD file, 2026-11-11]
hardware/mechanical/source/盒子.step
74.0 x 100.0 x 38.0 mm
