IWIN-FINS/FinsROV-Heavy/hardware/mechanical/source/设备舱/舱内/3mf格式/电调固定板.3mf

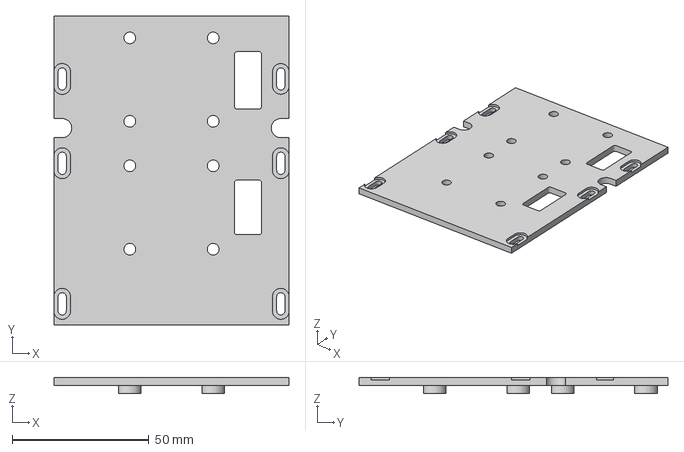
[picture p25: CAD file, 2026-11-11]
hardware/mechanical/source/设备舱/舱内/3mf格式/电调固定板.3mf
86.0 x 113.0 x 6.00 mm
