IWIN-FINS/FinsROV-Heavy/hardware/mechanical/source/设备舱/舱内/主控固定板.step

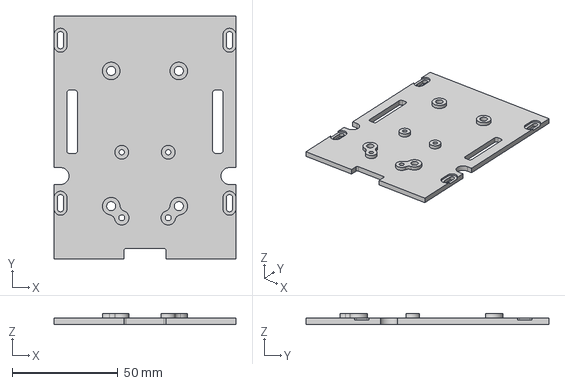
[picture p26: CAD file, 2026-11-11]
hardware/mechanical/source/设备舱/舱内/主控固定板.step
86.0 x 115.0 x 5.00 mm
