IWIN-FINS/FinsROV-Heavy/hardware/mechanical/source/框架V2/侧板V2.step

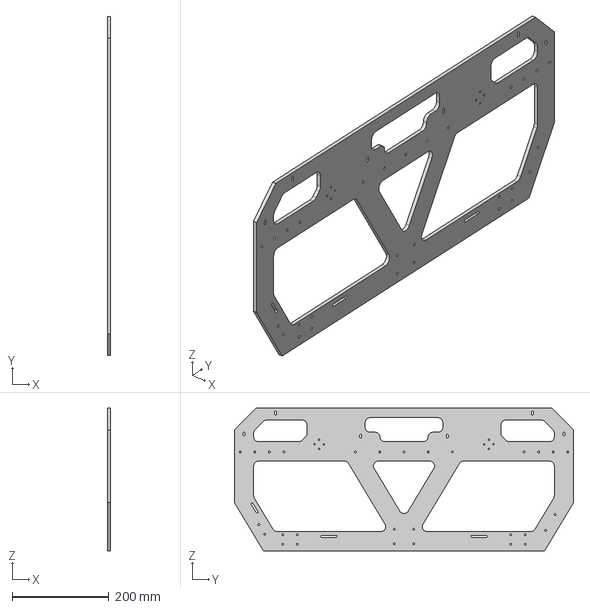
[picture p27: CAD file, 2026-11-11]
hardware/mechanical/source/框架V2/侧板V2.step
6.00 x 700.0 x 295.0 mm
