IWIN-FINS/FinsROV-Heavy/hardware/mechanical/source/线缆夹/云台线缆夹1号.step

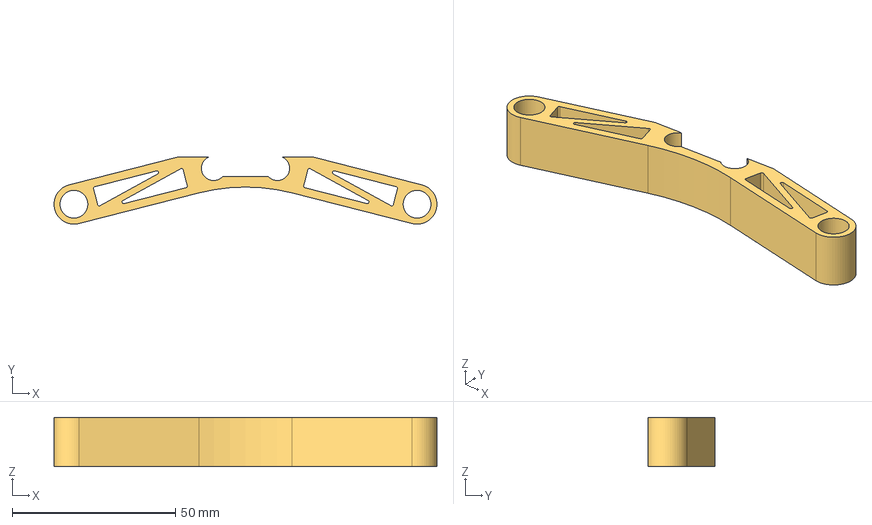
[picture p29: CAD file, 2026-11-11]
hardware/mechanical/source/线缆夹/云台线缆夹1号.step
117.2 x 20.6 x 15.0 mm
