IWIN-FINS/FinsROV-Heavy/hardware/mechanical/source/设备舱/舱内/3mf格式/上板.3mf

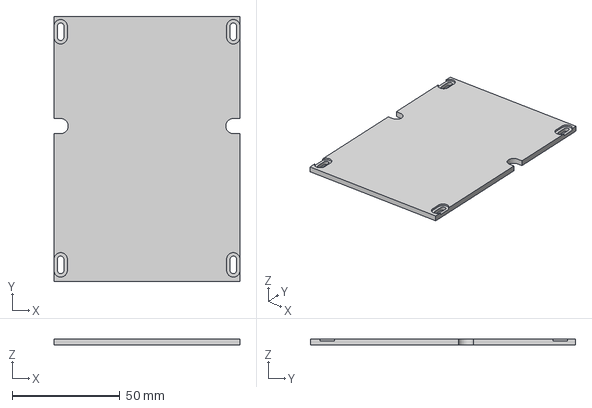
[picture p30: CAD file, 2026-11-11]
hardware/mechanical/source/设备舱/舱内/3mf格式/上板.3mf
86.0 x 122.7 x 3.00 mm
