IWIN-FINS/FinsROV-Heavy/hardware/mechanical/source/铅块垫片.step

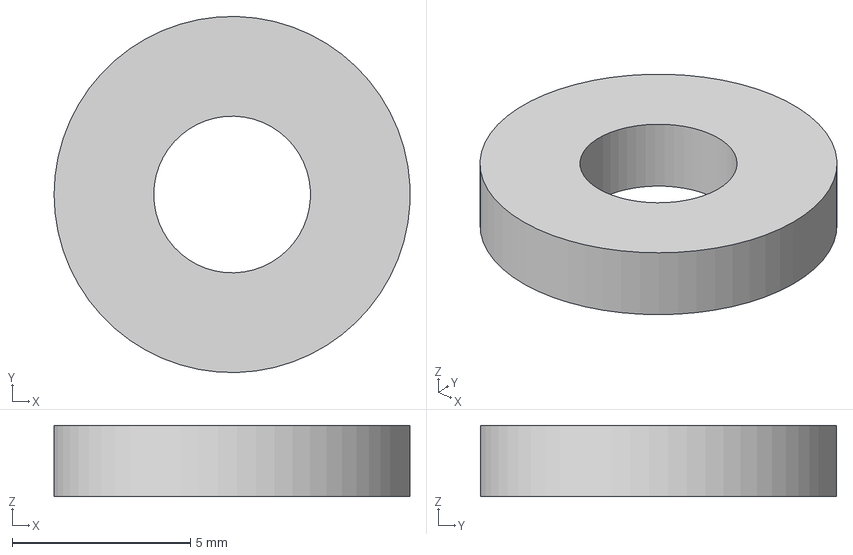
[picture p31: CAD file, 2026-11-11]
hardware/mechanical/source/铅块垫片.step
9.99 x 10.00 x 2.00 mm
