IWIN-FINS/FinsROV-Heavy/hardware/mechanical/source/IMU外壳 v5.step

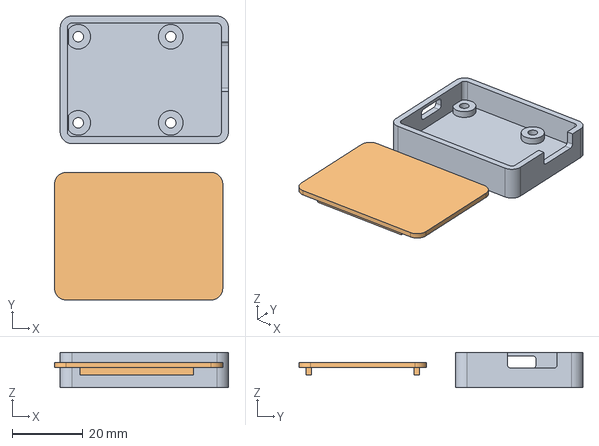
[picture p32: CAD file, 2026-11-11]
hardware/mechanical/source/IMU外壳 v5.step
49.1 x 80.1 x 10.0 mm
零部件1
零部件2
