IWIN-FINS/FinsROV-Heavy/hardware/mechanical/source/电池舱/电池舱后盖.step

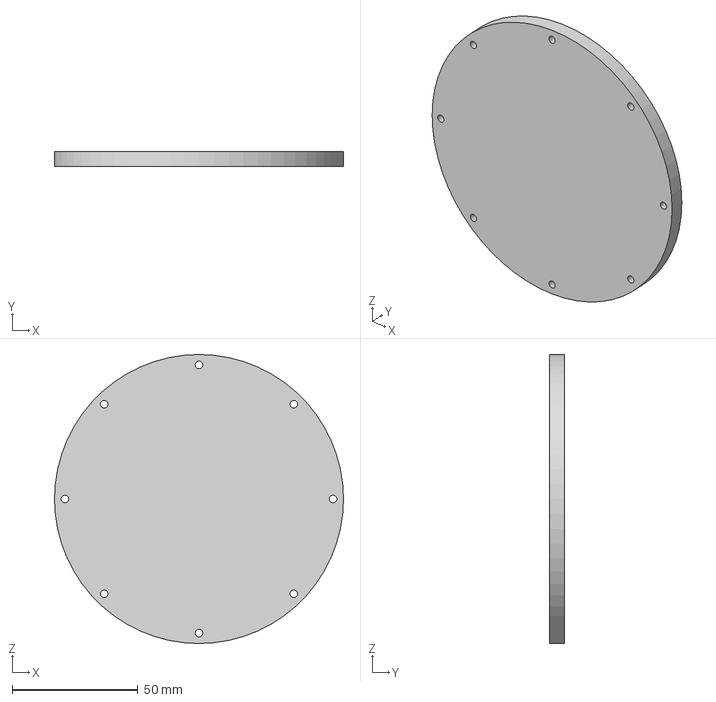
[picture p33: CAD file, 2026-11-11]
hardware/mechanical/source/电池舱/电池舱后盖.step
115.0 x 6.00 x 115.0 mm
