IWIN-FINS/FinsROV-Heavy/hardware/mechanical/source/线缆夹/4pin.3mf

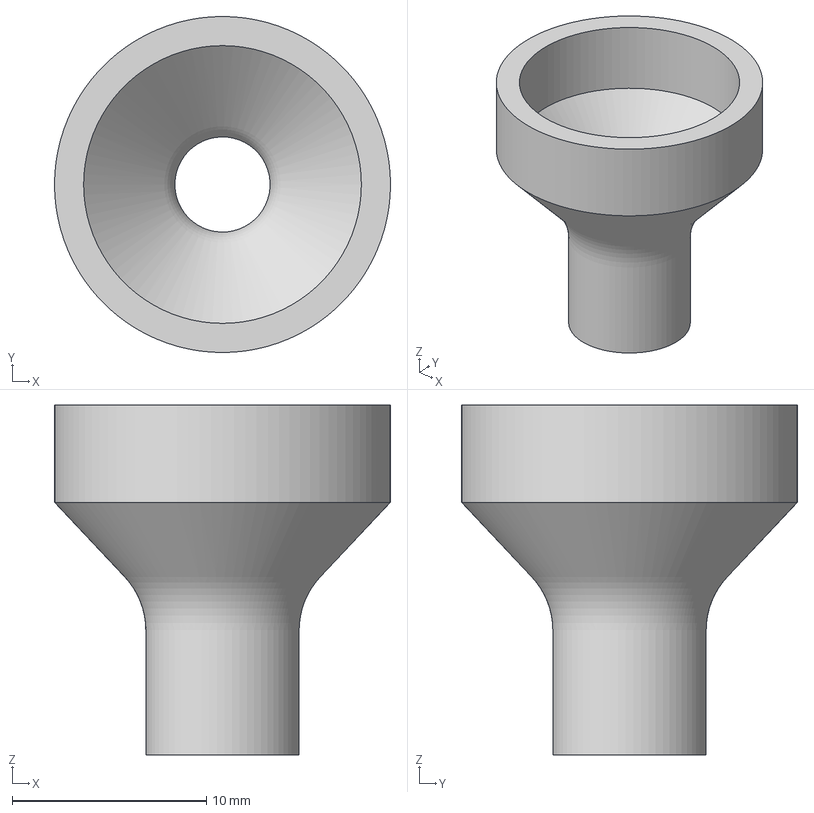
[picture p34: CAD file, 2026-11-11]
hardware/mechanical/source/线缆夹/4pin.3mf
17.3 x 17.3 x 18.0 mm
