IWIN-FINS/FinsROV-Heavy/hardware/mechanical/source/设备舱/舱内/对插板固定件.step

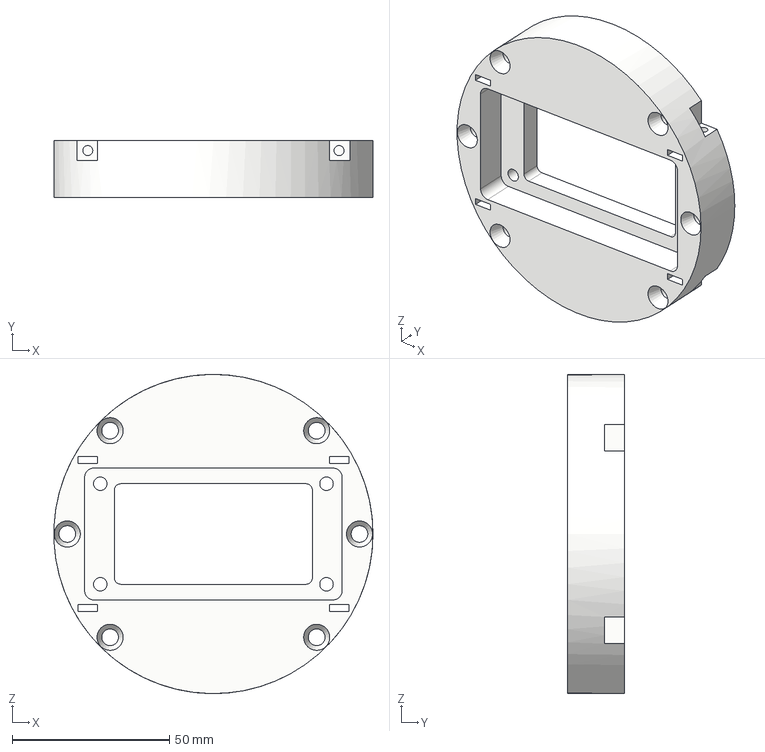
[picture p35: CAD file, 2026-11-11]
hardware/mechanical/source/设备舱/舱内/对插板固定件.step
101.5 x 18.0 x 101.6 mm
