IWIN-FINS/FinsROV-Heavy/hardware/mechanical/source/框架/云台支架.step

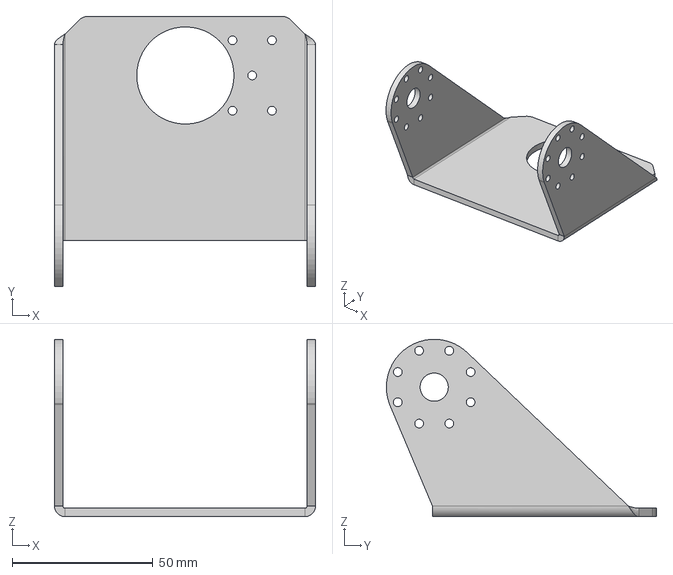
[picture p38: CAD file, 2026-11-11]
hardware/mechanical/source/框架/云台支架.step
92.7 x 96.0 x 63.0 mm
