IWIN-FINS/FinsROV-Heavy/hardware/mechanical/source/线缆夹/线缆对接灌胶管.step

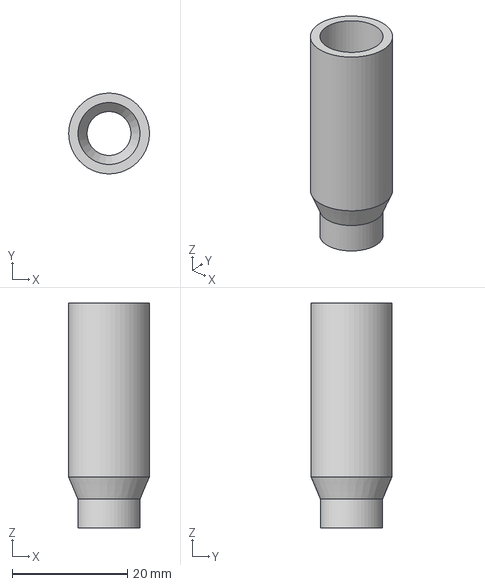
[picture p39: CAD file, 2026-11-11]
hardware/mechanical/source/线缆夹/线缆对接灌胶管.step
14.0 x 14.0 x 39.0 mm
