IWIN-FINS/FinsROV-Heavy/hardware/mechanical/source/框架/相机支架 v21.step

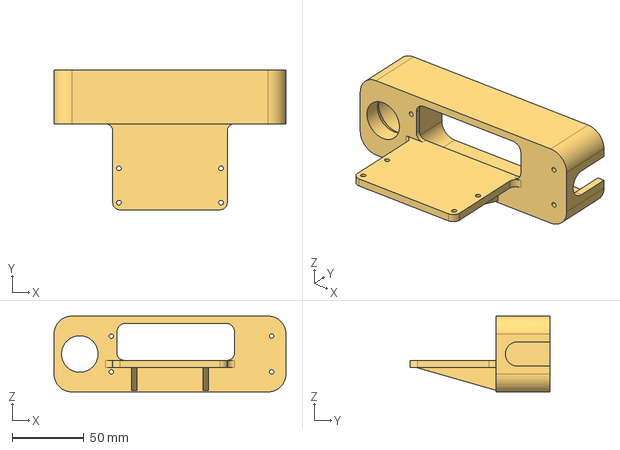
[picture p40: CAD file, 2026-11-11]
hardware/mechanical/source/框架/相机支架 v21.step
162.0 x 97.5 x 53.0 mm
