IWIN-FINS/FinsROV-Heavy/hardware/mechanical/source/线缆夹/光轴短套管.step

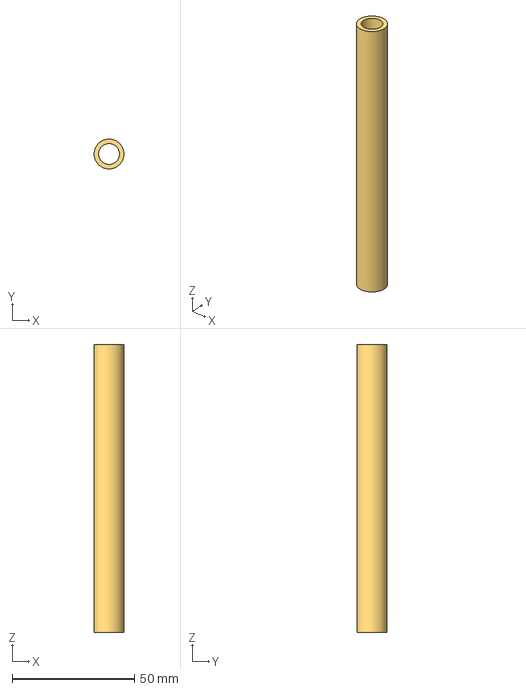
[picture p41: CAD file, 2026-11-11]
hardware/mechanical/source/线缆夹/光轴短套管.step
12.2 x 12.2 x 117.6 mm
