IWIN-FINS/FinsROV-Heavy/hardware/mechanical/source/框架/固定块R.step

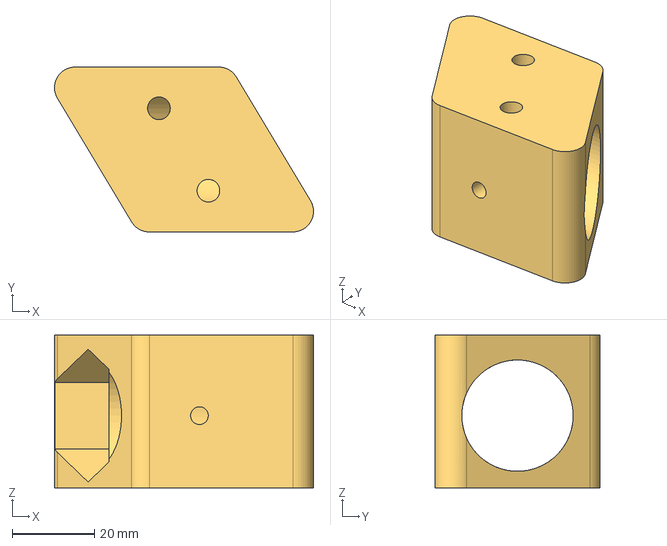
[picture p42: CAD file, 2026-11-11]
hardware/mechanical/source/框架/固定块R.step
62.8 x 40.0 x 37.0 mm
