IWIN-FINS/FinsROV-Heavy/hardware/mechanical/source/框架/横梁.step

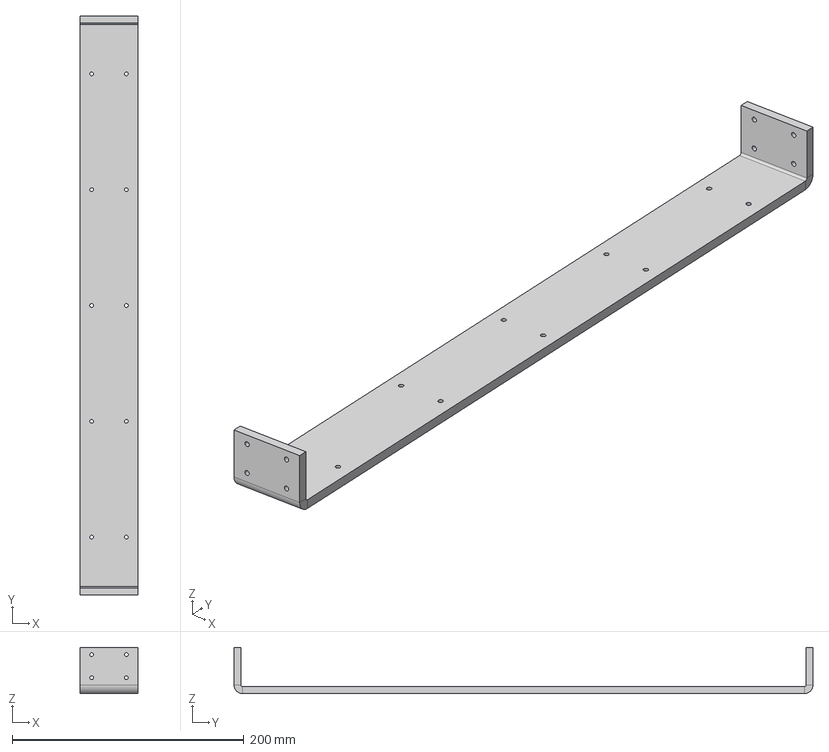
[picture p43: CAD file, 2026-11-11]
hardware/mechanical/source/框架/横梁.step
50.0 x 500.0 x 40.0 mm
