IWIN-FINS/FinsROV-Heavy/hardware/mechanical/source/框架/光轴夹垫片.step

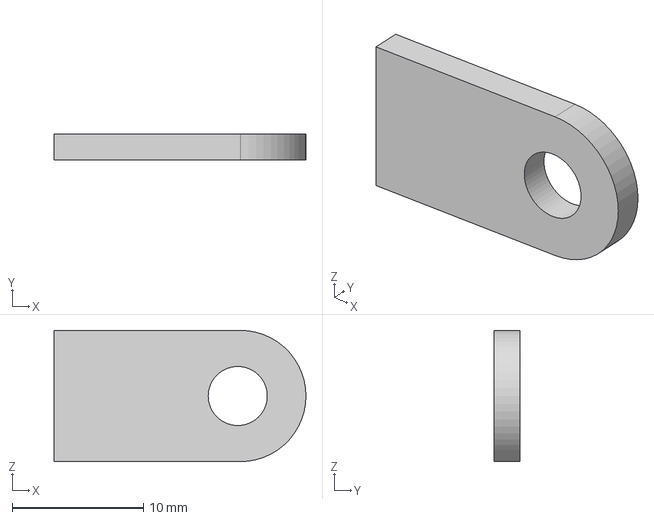
[picture p44: CAD file, 2026-11-11]
hardware/mechanical/source/框架/光轴夹垫片.step
19.2 x 2.00 x 10.0 mm
