IWIN-FINS/FinsROV-Heavy/hardware/mechanical/source/框架/线夹 v1.step

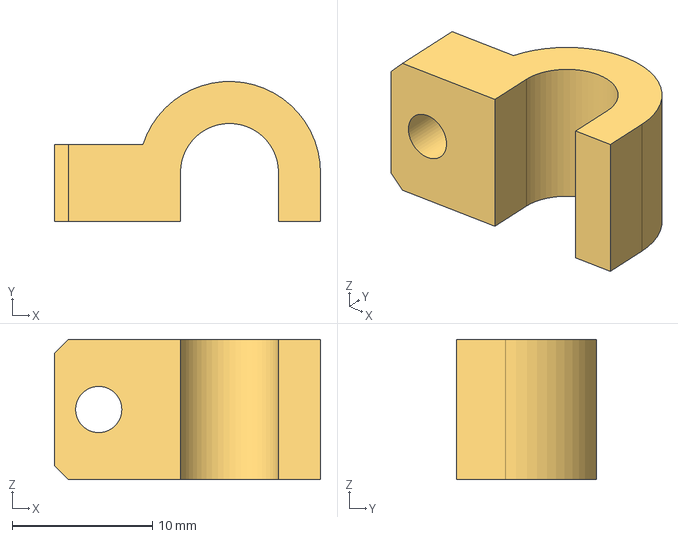
[picture p45: CAD file, 2026-11-11]
hardware/mechanical/source/框架/线夹 v1.step
19.0 x 10.00 x 10.0 mm
