IWIN-FINS/FinsROV-Heavy/(list of files, cad)

Other CAD files:
hardware/mechanical/source/设备舱/舱内/3mf格式/ORIN NX固定板.3mf
hardware/mechanical/source/框架V2/顶板V2.step
hardware/mechanical/source/线缆夹/3pin.3mf
hardware/mechanical/source/框架/电机线夹片.step
hardware/mechanical/source/设备舱/舱内/上板.step
hardware/mechanical/source/框架/阿卡插座.step
hardware/mechanical/source/设备舱/舱内/3mf格式/主控固定板.3mf
hardware/mechanical/source/设备舱/舱内/电源底板.step
hardware/mechanical/source/线缆夹/云台线缆夹2号.step
hardware/mechanical/source/设备舱/舱内/电调固定板.step
hardware/mechanical/source/框架/侧板.step
hardware/mechanical/source/线缆夹/4pin细线缆管.step
hardware/mechanical/source/框架/二合一固定块L.step
hardware/mechanical/source/框架/浮力块 v1.step
hardware/mechanical/source/框架/固定块L.step
hardware/mechanical/source/框架/电机线夹4pin.step
hardware/mechanical/source/铅块垫片.f3d
