IWIN-FINS/FinsROV-Heavy/hardware/pcb/assembly/README.md

# Power board assembly / 电源板装联

[焊接教程](../../../docs/build/03-power-board.zh-CN.md) · [Project home](../../../README.md)

Download [interactive-bom.html](interactive-bom.html?raw=true) and open it locally in a browser. GitHub does not execute the interactive HTML in its file viewer. The source attachment was named `InteractiveBOM_PCB2_1_2026-4-8 (1).html` and has been preserved byte-for-byte.

**Resolve the R12 revision discrepancy before assembly.** The supplied notes say not to populate R12, but also say the design was corrected. The HTML still lists R12 (10 kΩ, R0603, C25804) with `is_mount: true`. Its revision relationship to [PowerBoard.zip](../PowerBoard.zip?raw=true) and the live EasyEDA project is unconfirmed. No board data has been altered to guess the answer.

下载后在本地浏览器打开交互式 BOM。焊接前先核对 R12 的板版差异，详见上方教程；该 HTML 不替代贴片厂需要的坐标文件和明确的 DNP 清单。第三方生成器的原有声明保留在 HTML 中。
