IWIN-FINS/FinsROV-Heavy/docs/build/05-pressure-sensors.zh-CN.md

# 05 · 水压计配置

[教程目录](../README.zh-CN.md) · 上一步：[推进器接线](04-thrusters.zh-CN.md) · 下一步：[Jetson](06-jetson.zh-CN.md)

本机使用四只 RS-485 压力变送器。BOM 记录型号为 PCM300Y；原调试软件包的文件名包含 PCM380，这不等于实装传感器型号发生变更，使用前向供应商核对软件与传感器固件的适配性。

## 参数表

| 参数 | 本机配置 |
| --- | --- |
| 通信波特率 | 115200；原记录中的出厂值为 9600，实际以传感器读回值为准 |
| 压力单位 | Pa |
| 小数点设置 | 3 位 |
| 其他参数 | 原记录保持默认，写入前保存本只传感器的读回值 |
| 固件接口 | RoboMaster A 的 UART8，地址 0x01–0x04 |

从上方俯视，朝向与机身 X 轴向前一致：

| 位置 | 地址 |
| --- | --- |
| 左前 | 1 / 0x01 |
| 左后 | 2 / 0x02 |
| 右后 | 3 / 0x03 |
| 右前 | 4 / 0x04 |

## 逐只配置

1. 一次连接一只传感器，确认供电与 RS-485 A/B 定义符合其规格。
2. 在厂商调试工具中选择串口与当前波特率，执行“搜索 → 连接 → 读取”。未修改的传感器先尝试原记录中的 9600。
3. 保存读回参数，设置对应地址、115200、Pa、3 位小数后写入。
4. 按新波特率和地址重新连接并读取，确认写入成功；给传感器与线缆贴上位置标签。
5. 四只全部完成后接入总线，检查地址无冲突、四路读数持续更新且位置对应正确。

[下载原附调试软件](../reference/PCM380曲线拟合调试软件用户版V0.1.rar?raw=true) · [下载操作录像](<../reference/用户调试软件V0.1 2025-10-29 16-39-50.mp4?raw=true>)

录像由原制作记录提供；工具包原样保留，整理时未运行其中的程序。

## 压力配置与深度零偏分开核对

通信成功不代表深度标定已经完成。两套固件的 `V5_SUB.hpp` 中有实机压力零偏与控制参数，复现时应重新测量本机四路零偏并记录测量条件，不能直接把原机常数当作新传感器的标定值。[固件配置入口](../../firmware/README.zh-CN.md#源码入口)
