IWIN-FINS/FinsROV-Heavy/docs/build/07-bring-up.zh-CN.md

# 07 · 联调检查与待补资料

[教程目录](../README.zh-CN.md) · 上一步：[Jetson 配置](06-jetson.zh-CN.md)

## 按链路逐级检查

| 阶段 | 检查内容 | 通过的依据 |
| --- | --- | --- |
| 机械装配 | 框架、安装座、浮力块、推进器、线夹、舱内支架 | 孔位匹配、方向与编号一致、线缆不被夹压，未确认的孔径与线夹版本有记录 |
| 电源板 | 板版、R12、极性、焊点、输入输出 | 先解决 R12 版本冲突；板级测试结果符合确认的原理图 |
| 传感器 | 四个压力地址与位置，IMU 型号和方向 | 0x01–0x04 均持续更新，单位及零偏已核对 |
| 网络 | PC 与 Jetson 直连后再接载波 | ping、视频、控制与遥测分别通过 |
| 串口 | UART3 与 `/dev/ttyTHS1`、针序、权限、固件版本 | 手柄输入使对应控制字段变化，帧格式与所选固件一致 |
| 推进器 | 逐路物理编号、电调焊盘、DShot 通道及桨向 | 每次只检查目标通道，实际旋向和布置图一致 |
| 自启动 | 正常启动、单程序退出、重启 | 日志可定位问题；重启后服务恢复，无重复占用串口 |
| 完整系统 | 实装载荷、配重、控制参数、密封与下水前检查 | 按补齐后的实机试验规程验收，并记录结果 |

原资料尚未给出完整密封装配、泄漏检查、耐压验证和下水验收流程。本清单用于组织联调，不构成整机耐压或下水合格证明。浮力材料标注的 250 m 不替代整机试验。

## 待补资料

下列问题集中保留在这里，相关章节也就地标注。

| 优先级 | 缺失或冲突 | 需要补充的内容 |
| --- | --- | --- |
| 接线/焊接前 | R12“不焊”与交互式 BOM 的装配标记冲突 | 手上 PCB、立创工程、Gerber、HTML 是否同版；哪个版本需要不焊 R12 |
| 采购/打印前 | 教程为 8 个电机线夹，STEP 夹体合计 4 件 | 实机所用模型名、每种数量、是否包含压板；具体打印工艺和耗材 |
| 裁线前 | 1/8、2/7、3/6、4/5 号线缆长度空缺 | 各组裁线长度、从哪里量到哪里、端接预留量 |
| 操控联调前 | Windows 上位机未提供；实验固件无匹配 Jetson 桥接程序 | 源码或可发布版本、依赖与启动说明；实验版配套主机软件 |
| 电源上电前 | 缺完整供电、插头和转接板逐针接线表 | 最终电源拓扑、每个接口针序、线径、电池规格与保护设置 |
| 实装完善 | 阿卡滑座/角码、主舱与附件安装照片缺失 | 角码定位近照、滑座与 EN-04 的关系、剩余紧固件规格和数量 |
| 首次下水前 | 缺密封、泄漏、耐压与配平试验步骤 | 密封圈和紧固要求、试验设备/条件/判据、实测深度及配重位置 |
| 材料加工前 | 一处旧框架孔偏小、横梁/线夹存在版本差异 | 最终修订模型、孔/螺纹核验；打印耗材、方向、层高与填充 |

## 本次整理已验证的范围

文档目录和相对链接、原附件校验、BOM 两种格式一致性，以及 Jetson 脚本的离线协议和视频管线检查会随发布核验。固件既有编译记录见[固件说明](../../firmware/README.zh-CN.md)。本次未重新烧录固件、运行第三方调参工具或进行机器人硬件试验。
