IWIN-FINS/FinsROV-Heavy/hardware/mechanical/source/框架/侧板图纸.pdf

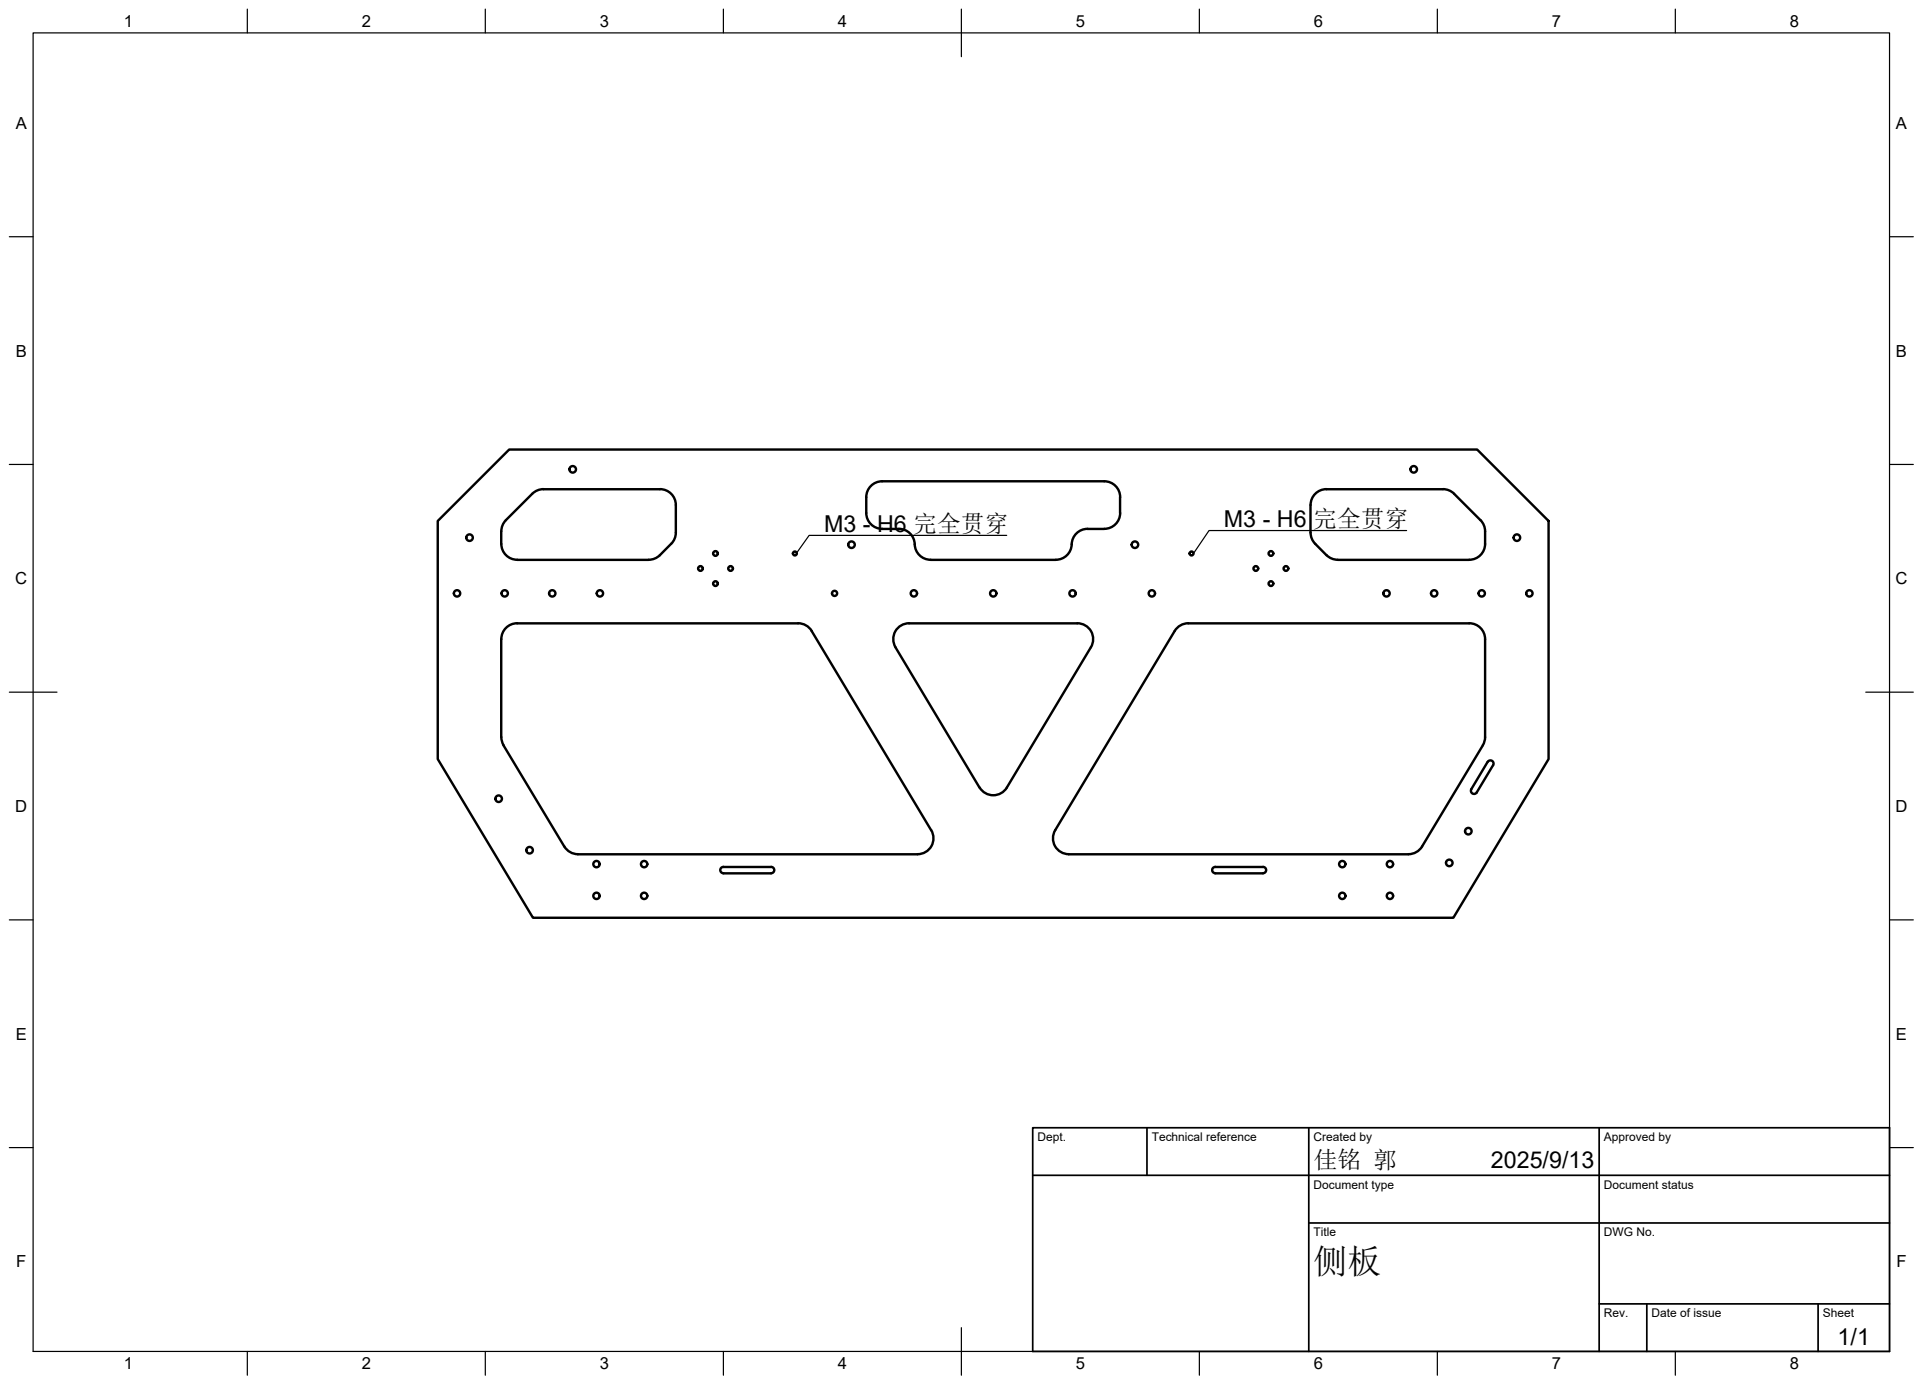
[picture p69: page 1]
Title; DWG No.; Rev.; Date of issue; Sheet; M3 - H6 完全贯穿

Dept. | Technical reference | Created by 佳铭 郭 2025/9/13 | Approved by

Document type | Document status
