IWIN-FINS/FinsROV-Heavy/hardware/mechanical/source/框架V2/横梁图纸.pdf

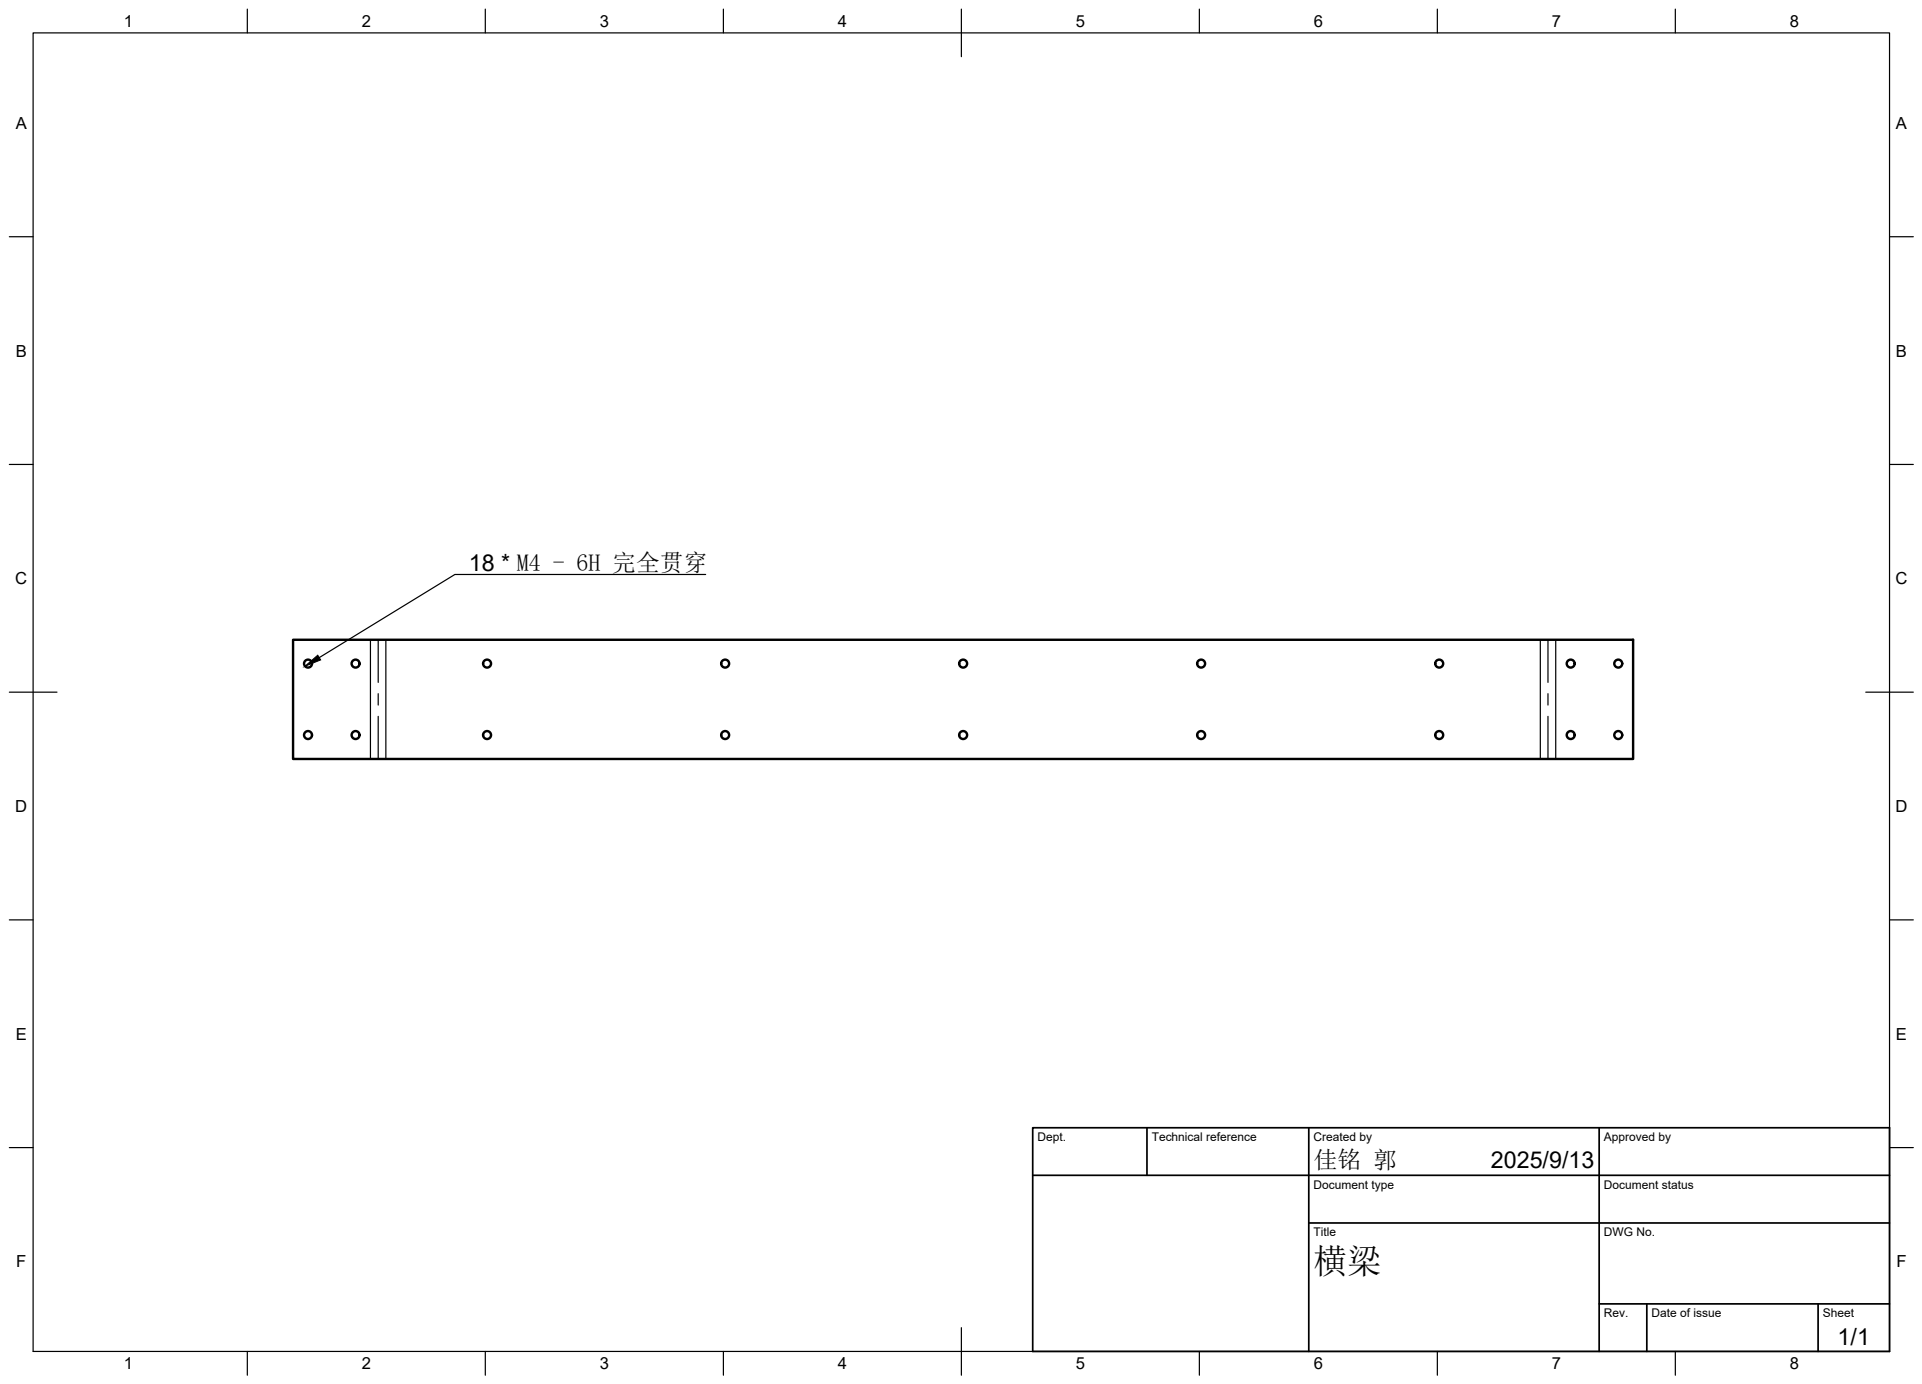
[picture p70: page 1]
Title; DWG No.; Rev.; Date of issue; Sheet; 18 * M4 - 6H 完全贯穿

Dept. | Technical reference | Created by 佳铭 郭 2025/9/13 | Approved by

Document type | Document status
