IWIN-FINS/FinsROV-Heavy/hardware/mechanical/source/框架V2/顶板图纸.pdf

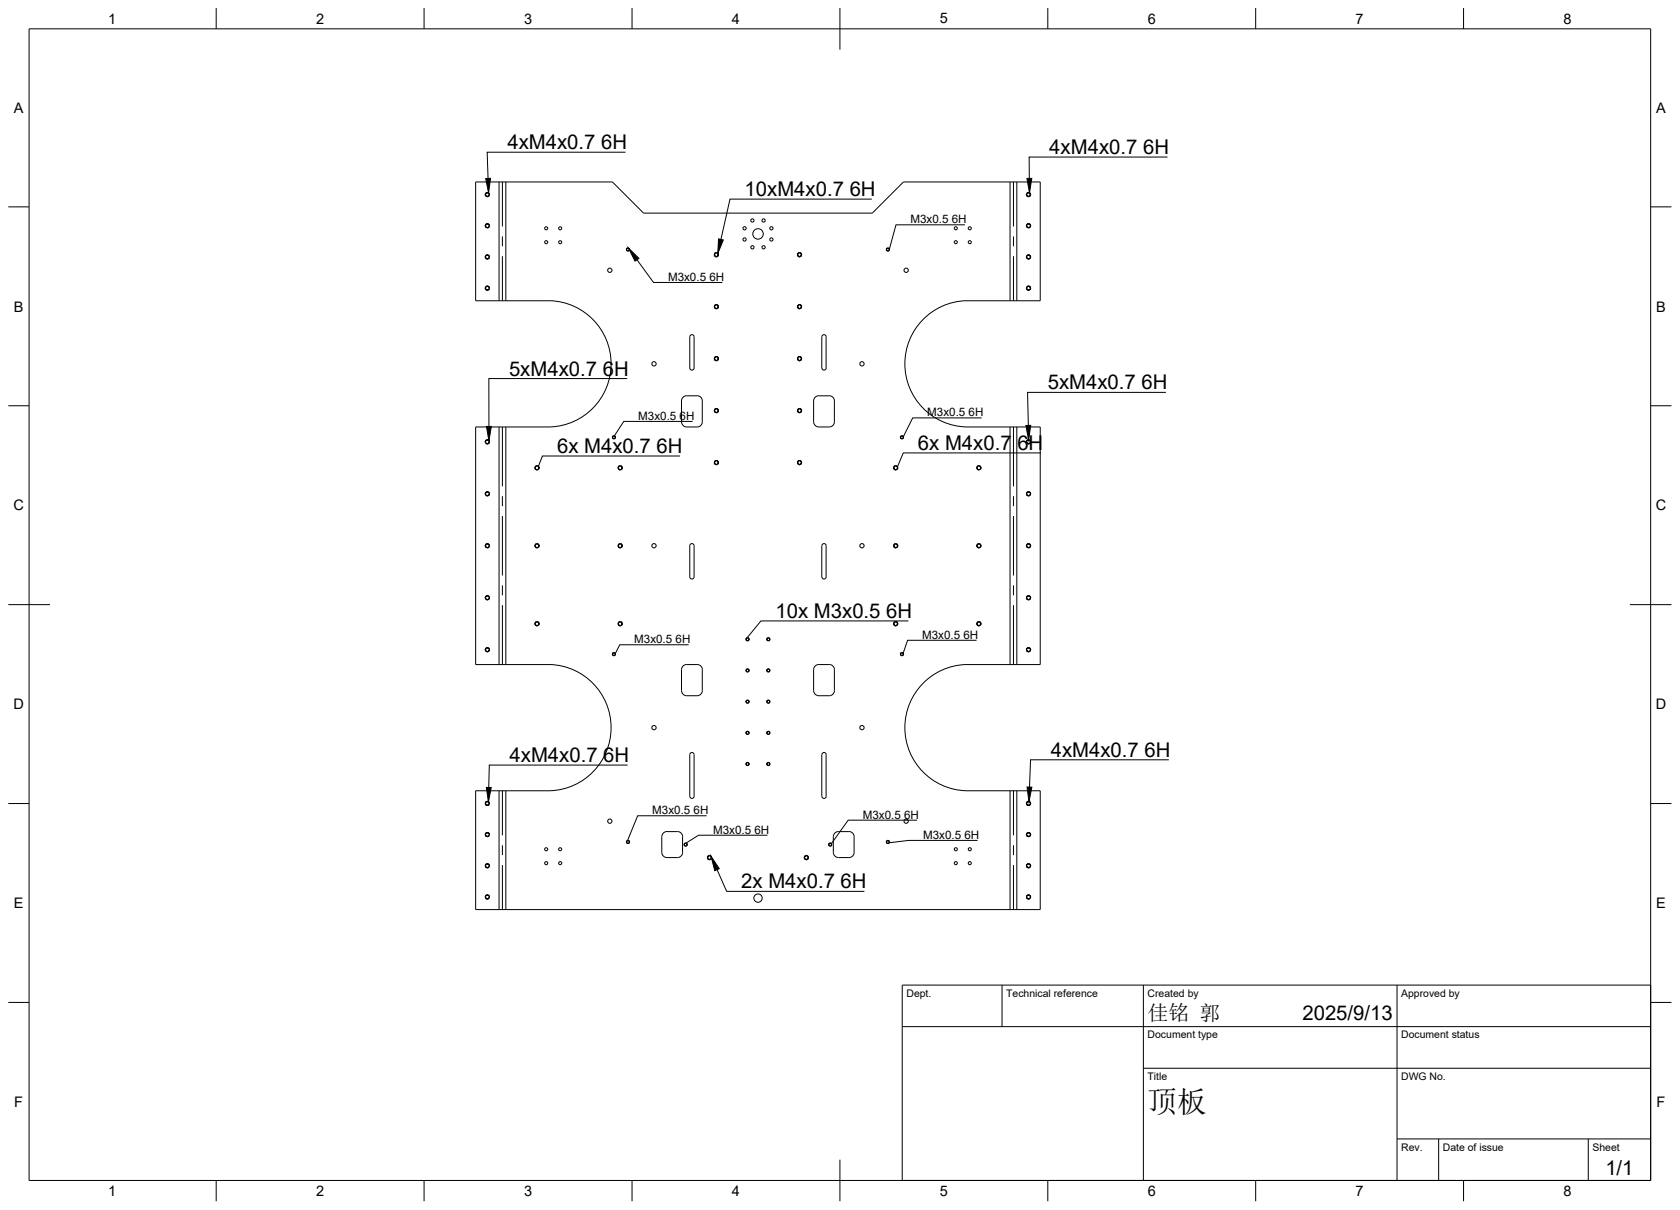
[picture p71: page 1]

Dept. | Technical reference | Created by 佳铭 郭 2025/9/13 | Approved by

Document type | Document status

Title 顶板 | DWG No.

Rev. | Date of issue | Sheet 1/1
