IWIN-FINS/FinsROV-Heavy/firmware/SUB/BSP/Robomaster_A/Core/Src/main.c

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
/* Includes ------------------------------------------------------------------*/
#include "main.h"
#include "adc.h"
#include "can.h"
#include "dma.h"
#include "i2c.h"
#include "iwdg.h"
#include "spi.h"
#include "tim.h"
#include "usart.h"
#include "usb_otg.h"
#include "gpio.h"


void SystemClock_Config(void);
/* USER CODE BEGIN PFP */
void SystemClock_PreConfig(void);
void SystemClock_PostConfig(void);

void BSP_Setup();
void Setup();
void Loop();
/* USER CODE END PFP */

/**
  * @brief  The application entry point.
  * @retval int
  */
int main(void)
{

  /* USER CODE BEGIN 1 */
  static uint8_t firstEnter = 1;
  if(firstEnter) {
  /* USER CODE END 1 */

  /* MCU Configuration--------------------------------------------------------*/

  /* Reset of all peripherals, Initializes the Flash interface and the Systick. */
  HAL_Init();

  /* USER CODE BEGIN Init */
    SystemClock_PreConfig();
  /* USER CODE END Init */

  /* Configure the system clock */
  SystemClock_Config();

  /* USER CODE BEGIN SysInit */
    SystemClock_PostConfig();
  /* USER CODE END SysInit */

  /* Initialize all configured peripherals */
  MX_GPIO_Init();
  MX_DMA_Init();
  MX_CAN1_Init();
  MX_CAN2_Init();
  MX_I2C2_Init();
  MX_TIM2_Init();
  MX_TIM4_Init();
  MX_TIM5_Init();
  MX_TIM8_Init();
  MX_TIM12_Init();
  MX_UART7_Init();
  MX_UART8_Init();
  MX_USART1_UART_Init();
  MX_USART3_UART_Init();
  MX_USART6_UART_Init();
  MX_USB_OTG_FS_USB_Init();
  MX_TIM1_Init();
  MX_SPI4_Init();
  MX_ADC1_Init();
  MX_IWDG_Init();
  MX_TIM7_Init();
  MX_USART2_UART_Init();
  MX_SPI5_Init();
  /* USER CODE BEGIN 2 */
    HAL_GPIO_WritePin(LED_G1_GPIO_Port, LED_G1_Pin|LED_G2_Pin|LED_G3_Pin|LED_G4_Pin|LED_G5_Pin|LED_G6_Pin|LED_G7_Pin|LED_G8_Pin, GPIO_PIN_SET);
    HAL_GPIO_WritePin(LED_GREEN_GPIO_Port, LED_GREEN_Pin, GPIO_PIN_SET);

    firstEnter = 0;
  }
  else {
    BSP_Setup();
    Setup();
  /* USER CODE END 2 */

  /* Infinite loop */
  /* USER CODE BEGIN WHILE */
  while (1) {
    /* USER CODE END WHILE */

    /* USER CODE BEGIN 3 */
      Loop();
    }
  }
  /* USER CODE END 3 */
}

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
/* USER CODE BEGIN 4 */
/**
 * @brief 将时钟源选择为内部时钟，避免Clion的Debug模式无法使能锁相环
 */
void SystemClock_PreConfig(void) {
  RCC_ClkInitTypeDef RCC_ClkInitStruct = {0};
  RCC_ClkInitStruct.ClockType = RCC_CLOCKTYPE_SYSCLK;
  RCC_ClkInitStruct.SYSCLKSource = RCC_SYSCLKSOURCE_HSI;
  if (HAL_RCC_ClockConfig(&RCC_ClkInitStruct, FLASH_LATENCY_5) != HAL_OK) {
    Error_Handler();
  }
}

void SystemClock_PostConfig(void) {
  RCC_OscInitTypeDef RCC_OscInitStruct = {0};
  RCC_OscInitStruct.OscillatorType = RCC_OSCILLATORTYPE_HSI;
  RCC_OscInitStruct.HSIState = RCC_HSI_OFF;
  RCC_OscInitStruct.PLL.PLLState = RCC_PLL_NONE;
  if(HAL_RCC_OscConfig(&RCC_OscInitStruct) != HAL_OK) {
    Error_Handler();
  }
}
/* USER CODE END 4 */
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
