IWIN-FINS/FinsROV-Heavy/firmware/inertial-odometry/BSP/MC_Board/MC_Board.h

/*******************************************************************************
 * Copyright (c) 2023.
 * IWIN-FINS Lab, Shanghai Jiao Tong University, Shanghai, China.
 * All rights reserved.
 ******************************************************************************/

#ifndef FINEMOTE_MC_BOARD_H
#define FINEMOTE_MC_BOARD_H

#include "main.h"
#include "adc.h"
#include "can.h"
#include "dma.h"
#include "i2c.h"
#include "spi.h"
#include "tim.h"
#include "usart.h"
#include "gpio.h"
#include "iwdg.h"
#include "stm32f4xx_it.h"

int main();

class PeripheralsInit {

    PeripheralsInit() {
        main();
    }

public:
    PeripheralsInit(const PeripheralsInit &) = delete;

    PeripheralsInit &operator=(const PeripheralsInit &) = delete;

    static PeripheralsInit &GetInstance() {
        static PeripheralsInit instance;
        return instance;
    }
};

/**
 * UART Definitions
 */
constexpr UART_HandleTypeDef *BSP_UARTList[] = {nullptr, &huart1, &huart2, &huart3, nullptr, &huart5};
constexpr size_t UART_BUS_MAXIMUM_COUNT = sizeof(BSP_UARTList) / sizeof(BSP_UARTList[0]) - 1;

/**
 * RS485 Definitions
 */
constexpr size_t BSP_RS485UARTIndexList[] = {0, 1, 2};
constexpr size_t RS485_BUS_MAXIMUM_COUNT = sizeof(BSP_RS485UARTIndexList) / sizeof(BSP_RS485UARTIndexList[0]) - 1;

inline GPIO_TypeDef *const BSP_RS485FlowCtrlPortList[3] = {nullptr, GPIOC, GPIOB};
constexpr uint16_t BSP_RS485FlowCtrlPinList[3] = {0, GPIO_PIN_15, GPIO_PIN_3};

/**
 * CAN Definitions
 */
constexpr CAN_HandleTypeDef *BSP_CANList[] = {nullptr, &hcan1, &hcan2};
constexpr size_t CAN_BUS_MAXIMUM_COUNT = sizeof(BSP_CANList) / sizeof(BSP_CANList[0]) - 1;

/**
 * DHSOT Definitions
 */
extern DMA_HandleTypeDef hdma_tim1_up;
#define DSHOT_TRANSMIT_DMA_HANDLE hdma_tim1_up
#define DSHOT_DMA_TIM htim1
#define DSHOT_PACK_HEAD_LENGTH 2
#define DSHOT_PACK_TAIL_LENGTH 2
#define DSHOT_FRAME_LENGTH 16
#define DSHOT_PACK_LENGTH (DSHOT_FRAME_LENGTH + DSHOT_PACK_HEAD_LENGTH + DSHOT_PACK_TAIL_LENGTH)
#define DSHOT_RX_LENGTH 100
inline GPIO_TypeDef *const BSP_DHOSTPortList[5] = {nullptr, GPIOC, GPIOC, GPIOC, GPIOC};
constexpr size_t BSP_DHOSTPinList[5] = {0, GPIO_PIN_6, GPIO_PIN_7, GPIO_PIN_8, GPIO_PIN_9};

/**
 * PWM Definitions
 */
constexpr struct {
  uint32_t TIM_CHANNEL;
  TIM_HandleTypeDef *TIM_Handle = nullptr;
  uint16_t TIM_Frequency = 168; // Default frequency
} BSP_PWMList[6] = {
  {0, nullptr, 0},
  {TIM_CHANNEL_1, &htim8, 168},
  {TIM_CHANNEL_2, &htim8, 168},
  {TIM_CHANNEL_3, &htim8, 168},
  {TIM_CHANNEL_4, &htim8, 168},
  {TIM_CHANNEL_4, &htim2, 84}  // BUZZER_PWM
};

/**
 * BUZZER Definitions
 */
#define BUZZER_PWM_ID 5
#define BUZZER_PERIPHERAL

#define LED_GPIO_Port   GPIOC
#define LED_Pin         GPIO_PIN_0
#define LED_PERIPHERAL

#define TIM_Heater htim3
#define TIM_Heater_Channel TIM_CHANNEL_2

#define TIM_Control htim7

typedef struct {
    SPI_HandleTypeDef *spiHandle;
    DMA_HandleTypeDef *rxDMAHandle;
    DMA_HandleTypeDef *txDMAHandle;
    TIM_HandleTypeDef *timHandleForHeat;
    uint32_t timChannelForHeat;
} SPI_WITH_DMA_t;

extern SPI_WITH_DMA_t spiWithDMA;

#endif
