IWIN-FINS/FinsROV-Heavy/firmware/inertial-odometry/Components/SUB/V5_SUB.hpp

/*******************************************************************************
 * Copyright (c) 2025.
 * IWIN-FINS Lab, Shanghai Jiao Tong University, Shanghai, China.
 * All rights reserved.
 ******************************************************************************/

#ifndef V5_SUB_HPP
#define V5_SUB_HPP

#define PRESSURE_SENSORS_INIT_SAMPLE_TIMES 1000
#define MOTOR_COUNT 8
#define PRESSURE_SENSOR_COUNT 4

#include "FillLight/SUBLAB_FillLight.hpp"
#include "ESC_Motors/ESC_Motor.hpp"
#include "PressureSensor/PressureSensorBase.hpp"
#include "IMUBase.hpp"
#include "Battery/Battery.hpp"
#include <array>
#include "Clamp.hpp"
#include "arm_math.h"
#include "Matrix/matrix.h"
#include "Control/PID.hpp"
#include "Verification/CRC.h"

struct SUB_Motor_t {
    ESC_Motor *motor;
    float lx;
    float ly;
    float lz;
};

struct SUB_Pressure_Sensor_t {
    PressureSensorBase *sensor;
    float lx;
    float ly;
    float lz;
};


class V5_SUB;

// V5_SUBBuilder 类定义
class V5_SUBBuilder {
public:
    V5_SUBBuilder() = default;

    V5_SUBBuilder& AddMotor(ESC_Motor* motor, float x, float y, float z) {
        if (motorCount < MOTOR_COUNT) {
            motors[motorCount++] = {motor, x, y, z};
        }
        return *this;
    }

    V5_SUBBuilder& AddPressureSensor(PressureSensorBase* sensor, float x, float y, float z) {
        if (sensorCount < PRESSURE_SENSOR_COUNT) {
            pressureSensors[sensorCount++] = {sensor, x, y, z};
        }
        return *this;
    }

    V5_SUBBuilder& AddIMU(IMUBase* imu) {
        this->imu = imu;
        return *this;
    }

    V5_SUBBuilder& AddController(ControllerBase* rollController_, ControllerBase* pitchController_, ControllerBase* yawController_, ControllerBase* deepthController_) {
        this->rollController = rollController_;
        this->pitchController = pitchController_;
        this->yawController = yawController_;
        this->deepthController = deepthController_;
        return *this;
    }

    V5_SUBBuilder& AddBattery(BatteryBase* battery_) {
        this->battery = battery_;
        return *this;
    }

    V5_SUB* Build();

    std::array<SUB_Motor_t, MOTOR_COUNT> motors{};
    size_t motorCount = 0;

    std::array<SUB_Pressure_Sensor_t, PRESSURE_SENSOR_COUNT> pressureSensors{};
    size_t sensorCount = 0;

    IMUBase* imu = nullptr;

    BatteryBase* battery = nullptr;

    ControllerBase* rollController;
    ControllerBase* pitchController;
    ControllerBase* yawController;
    ControllerBase* deepthController;
};


class V5_SUB : public DeviceBase {
public:
    // 使用固定参数列表的构造函数
    explicit V5_SUB(V5_SUBBuilder const &temp) {
        this->motors = temp.motors;
        this->pressureSensors = temp.pressureSensors;
        this->imu = temp.imu;
        this->battery = temp.battery;
        this->rollController = temp.rollController;
        this->pitchController = temp.pitchController;
        this->yawController = temp.yawController;
        this->deepthController = temp.deepthController;

        rollController->SetFeedback({&currentAngleRate[0][0]});
        pitchController->SetFeedback({&currentAngleRate[1][0]});
        yawController->SetFeedback({&currentAngleRate[2][0]});
        deepthController->SetFeedback({&currentDeepth});
        rollController->SetTarget(&targetAngleRate[0][0]);
        pitchController->SetTarget(&targetAngleRate[1][0]);
        yawController->SetTarget(&targetAngleRate[2][0]);
        deepthController->SetTarget(&targetDeepth);

        A = Matrixf<4,3>{motors[1].ly, -motors[1].lx, -1,
                            motors[2].ly, -motors[2].lx, -1,
                            motors[5].ly, -motors[5].lx, -1,
                            motors[6].ly, -motors[6].lx, -1};

        B = Matrixf<4, 3>{1, -1, 1,
                            -1, 1, 1,
                            1, 1, -1,
                            -1, -1, -1};
    }

    void EnableMotors() {
        for (auto &motor : motors) {
            motor.motor->EnableMotor();
        }
    }

    void DisableMotors() {
        for (auto &motor : motors) {
            motor.motor->DisableMotor();
        }
    }

    void Disarm() {
        state = SUB_STATE::STABILIZING;
    }

    void Command(float yawRate, float FBSpeed, float LRSpeed, float downSpeed, float upSpeed, uint8_t startButton) {
        UseIMUYaw();
        UpdateDepthTarget(downSpeed, upSpeed);
        targetAttitude[2][0] += yawRate * 0.001f * 0.4f;
        targetVel[0][0] = FBSpeed * 0.35f;
        targetVel[1][0] = LRSpeed * 0.35f;
        SwitchState(startButton);
    }

    void CommandPathTracking(float targetYaw, float FBThrottle, float LRThrottle,
                             float downSpeed, float upSpeed, uint8_t startButton) {
        UpdateDepthTarget(downSpeed, upSpeed);
        SwitchState(startButton);
        targetAttitude[2][0] = targetYaw;
        targetVel[0][0] = Clamp(FBThrottle, -0.3f, 0.3f);
        targetVel[1][0] = Clamp(LRThrottle, -0.3f, 0.3f);
    }

    void SetExternalYaw(float yaw, float yawRate) {
        externalYaw = yaw;
        externalYawRate = yawRate;
        useExternalYaw = true;
    }

    void UseIMUYaw() {
        if (useExternalYaw) {
            useExternalYaw = false;
            targetAttitude[2][0] = imu->getEulerArray()[2];
        }
    }

    void Handle() final {

        Update();//在更新控制器前先更新误差

        switch (state) {
            case SUB_STATE::INIT:
                PressureSensorInit();
                IMUInit();
                if (pressureInitFinished && imuInitFinished) {
                    state = SUB_STATE::IDLE;
                }
                break;
            case SUB_STATE::IDLE:
                break;
            case SUB_STATE::STABILIZING:
                StabilizeMode();
                rollController->Calc();
                pitchController->Calc();
                yawController->Calc();
                deepthController->Calc();
                MotorPowerDistribution();
                break;
            case SUB_STATE::POSITION_HOLDING:
                break;
            default:
                break;
        }

        static uint8_t cnt = 0;
        static float timeStamp = 0.f;
        cnt++;
        if(cnt >= 5) {
            cnt = 0;
            timeStamp += 0.005f;
            uploadData.depth = ((pressureSensors[0].sensor->GetPressure()
                                   + pressureSensors[1].sensor->GetPressure()
                                   + pressureSensors[2].sensor->GetPressure()
                                   + pressureSensors[3].sensor->GetPressure()) / 4.0f - 101325.0f) / 9806.65f;
            uploadData.accX = imu->getAccelArray()[0];
            uploadData.accY = imu->getAccelArray()[1];
            uploadData.accZ = imu->getAccelArray()[2];
            uploadData.gyroX = imu->getAngleRateArray()[0];
            uploadData.gyroY = imu->getAngleRateArray()[1];
            uploadData.gyroZ = imu->getAngleRateArray()[2];
            uploadData.roll = imu->getEulerArray()[0];
            uploadData.pitch = imu->getEulerArray()[1];
            uploadData.yaw = imu->getEulerArray()[2];
            uploadData.intRpm1 = motors[0].motor->GetIntRpm();
            uploadData.intRpm2 = motors[1].motor->GetIntRpm();
            uploadData.intRpm3 = motors[2].motor->GetIntRpm();
            uploadData.intRpm4 = motors[3].motor->GetIntRpm();
            uploadData.intRpm5 = motors[4].motor->GetIntRpm();
            uploadData.intRpm6 = motors[5].motor->GetIntRpm();
            uploadData.intRpm7 = motors[6].motor->GetIntRpm();
            uploadData.intRpm8 = motors[7].motor->GetIntRpm();
            uploadData.throttle1 = motors[0].motor->GetThrottle();
            uploadData.throttle2 = motors[1].motor->GetThrottle();
            uploadData.throttle3 = motors[2].motor->GetThrottle();
            uploadData.throttle4 = motors[3].motor->GetThrottle();
            uploadData.throttle5 = motors[4].motor->GetThrottle();
            uploadData.throttle6 = motors[5].motor->GetThrottle();
            uploadData.throttle7 = motors[6].motor->GetThrottle();
            uploadData.throttle8 = motors[7].motor->GetThrottle();
            uploadData.batteryVoltage = (battery != nullptr) ? battery->GetVoltage() : 0.0f;
            uploadData.timeStamp = timeStamp;
            memcpy(txBuffer, &uploadData, sizeof(uploadData));
            UART_Base<3>::GetInstance().Transmit(txBuffer, sizeof(uploadData));
        }
    }

private:
    enum class SUB_STATE {
        INIT = 0X00,
        IDLE = 0X01,
        STABILIZING = 0X02,
        POSITION_HOLDING = 0X03
    }state = SUB_STATE::INIT;

    struct UploadData {
        /*** 深度 ***/
        float depth{0.0f};
        /*** 三轴加速度 ***/
        float accX{0.0f};
        float accY{0.0f};
        float accZ{0.0f};
        /*** 三轴角速度 ***/
        float gyroX{0.0f};
        float gyroY{0.0f};
        float gyroZ{0.0f};
        /*** 三轴欧拉角 ***/
        float roll{0.0f};
        float pitch{0.0f};
        float yaw{0.0f};
        /*** 8路推进器转速反馈 ***/
        int16_t intRpm1{0};
        int16_t intRpm2{0};
        int16_t intRpm3{0};
        int16_t intRpm4{0};
        int16_t intRpm5{0};
        int16_t intRpm6{0};
        int16_t intRpm7{0};
        int16_t intRpm8{0};
        /*** 8路推进器油门指令 ***/
        float throttle1{0.0f};
        float throttle2{0.0f};
        float throttle3{0.0f};
        float throttle4{0.0f};
        float throttle5{0.0f};
        float throttle6{0.0f};
        float throttle7{0.0f};
        float throttle8{0.0f};
        /*** 电池电压 ***/
        float batteryVoltage{0.0f};
        float timeStamp{0.0f};
        uint8_t tail[4]{0x00, 0x00, 0x80, 0x7f};
    }uploadData __packed;

    static_assert(sizeof(UploadData) == 100, "UploadData must match the 100-byte dataset telemetry frame");


    uint8_t txBuffer[128]{};

    std::array<SUB_Motor_t, MOTOR_COUNT> motors{};
    std::array<SUB_Pressure_Sensor_t, PRESSURE_SENSOR_COUNT> pressureSensors{};
    IMUBase *imu = nullptr;
    BatteryBase *battery = nullptr;
    std::array<float, PRESSURE_SENSOR_COUNT> pressureSensorOffset = {102000.0f + 2600.0f, 101900.0f + 2600.0f, 101600.0f + 2600.0f, 102000.0f + 2600.0f};
    bool pressureInitFinished = false;
    bool imuInitFinished = false;
    Matrixf<3, 1> targetAttitude{};//欧拉角
    Matrixf<3, 1> targetAngleRate{};
    Matrixf<3, 1> currentAngleRate{};
    Matrixf<3, 1> currentAttitude{};
    Matrixf<3, 1> rollPitchDeepthControllerOutput{};
    Matrixf<3, 1> yawFbLrControllerOutput{};
    Matrixf<4,3> A{};
    Matrixf<4,3> B{};
    Matrixf<2, 1> targetVel{};//FB LR
    float targetDeepth{-0.1f}; //默认水压计平面深度
    float currentDeepth{0.0f};
    float externalYaw{0.0f};
    float externalYawRate{0.0f};
    bool useExternalYaw{false};


    //控制器
    ControllerBase* rollController;
    ControllerBase* pitchController;
    ControllerBase* yawController;
    ControllerBase* deepthController;

    void UpdateDepthTarget(float downSpeed, float upSpeed) {
        // targetDeepth += (downSpeed - upSpeed) * 0.001f * 0.1f;
        // targetDeepth = Clamp(targetDeepth, 0.0f, 10.0f);
    }

    static float NormalizeAngle(float angle) {
        constexpr float kPi = 3.14159265358979323846f;
        constexpr float kTwoPi = 2.0f * kPi;
        while (angle > kPi) angle -= kTwoPi;
        while (angle < -kPi) angle += kTwoPi;
        return angle;
    }

    /*** 水压计初始化，多次采样取平均offset ***/
    void PressureSensorInit() {
        // static std::array<float, PRESSURE_SENSOR_COUNT> pressureSampleSum = {0.0f};
        // static uint16_t sampleTimes = 0;

        if (pressureInitFinished) {
            return;
        }

        // 检查所有传感器是否有数据
        for (size_t i = 0; i < PRESSURE_SENSOR_COUNT; i++) {
            // if (pressureSensors[i].sensor->GetPressure() < 1.0f) {
            //     return; // 传感器无数据，跳过采样
            // }
            pressureInitFinished = true;
        }

        // // 累积所有传感器的采样值
        // for (size_t i = 0; i < PRESSURE_SENSOR_COUNT; i++) {
        //     pressureSampleSum[i] += pressureSensors[i].sensor->GetPressure();
        // }
        // sampleTimes++;
        //
        // if (sampleTimes == PRESSURE_SENSORS_INIT_SAMPLE_TIMES) {
        //     // 计算平均值作为offset
        //     for (size_t i = 0; i < PRESSURE_SENSOR_COUNT; i++) {
        //         pressureSensorOffset[i] = pressureSampleSum[i] / PRESSURE_SENSORS_INIT_SAMPLE_TIMES;
        //     }
        //     pressureInitFinished = true;
        // }
    }

    void IMUInit() {
        if(imuInitFinished) {
            return;
        }
        if(imu->IsDataGet()) {
            imuInitFinished = true;
            // targetAttitude = Matrixf<3,1>(imu->getEulerArray().data());
            targetAttitude[2][0] = imu->getEulerArray()[2];
        }
    }

    float SqrtControler(float error, float errorLimit, float accLimit, float p) {
        if(error > errorLimit) {
            error = errorLimit;
        }
        else if(error < -errorLimit) {
            error = -errorLimit;
        }

        if(errorLimit < 1e-6f) {
            // 二阶限制为零或负值，使用纯比例控制
            return error * p;
        }
        else if(p < 1e-6f) {
            // P项为零，但存在二阶限制
            if(error > 1e-6f) {
                return sqrtf(2 * accLimit * error);
            }
            else if (error < -1e-6f) {
                return -sqrtf(-2 * accLimit * error);
            }
            else {
                return 0.0f;
            }
        }
        else {
            // 同时存在P项和二阶限制
            float linear_dist = accLimit / (p * p);

            if(error > linear_dist) {
                return sqrtf(2.0 * accLimit * (error - (linear_dist / 2.0)));
            }
            else if (error < -linear_dist) {
                return -sqrtf(2.0 * accLimit * (-error - (linear_dist / 2.0)));
            }
            else {
                return error * p;
            }
        }
    }

    void Update() {
        currentAngleRate = imu->getAngleRateArray().data();
        currentAttitude = imu->getEulerArray().data();
        if (useExternalYaw) {
            currentAttitude[2][0] = externalYaw;
            currentAngleRate[2][0] = externalYawRate;
        }

        Matrixf<3,1> attitudeError = targetAttitude - currentAttitude;
        attitudeError[2][0] = NormalizeAngle(attitudeError[2][0]);
        targetAngleRate[0][0] = SqrtControler(attitudeError[0][0], 2.0f, 1.0f, 5.0f);
        targetAngleRate[1][0] = SqrtControler(attitudeError[1][0], 2.0f, 1.0f, 5.0f);
        targetAngleRate[2][0] = SqrtControler(attitudeError[2][0], 2.0f, 1.0f, 5.0f);

        //更新深度
        float waterPressure = ((pressureSensors[1].sensor->GetPressure() - pressureSensorOffset[1]) + (pressureSensors[3].sensor->GetPressure() - pressureSensorOffset[3]))/2;
        currentDeepth = waterPressure / 9.8f / 1000.f;
    }

    //电机推力分配
    void MotorPowerDistribution() {
        float rollOutput = Clamp(1 * rollController->GetOutput(), -0.2f, 0.2f);
        float pitchOutput = Clamp(1 * pitchController->GetOutput(), -0.2f, 0.2f);
        float yawOutput = Clamp(1 * yawController->GetOutput(), -0.2f, 0.2f);
        float deepthOutput = Clamp(1 * deepthController->GetOutput(), -0.5f, 0.5f);

        //垂直电机推力分配
        rollPitchDeepthControllerOutput[0][0] = rollOutput;
        rollPitchDeepthControllerOutput[1][0] = pitchOutput;
        rollPitchDeepthControllerOutput[2][0] = deepthOutput;

        Matrixf<4,1> upperMotorOutPut = A * rollPitchDeepthControllerOutput;
        upperMotorOutPut[0][0] = fabsf(upperMotorOutPut[0][0]) < 0.01f ? 0.0f : upperMotorOutPut[0][0];
        upperMotorOutPut[1][0] = fabsf(upperMotorOutPut[1][0]) < 0.01f ? 0.0f : upperMotorOutPut[1][0];
        upperMotorOutPut[2][0] = fabsf(upperMotorOutPut[2][0]) < 0.01f ? 0.0f : upperMotorOutPut[2][0];
        upperMotorOutPut[3][0] = fabsf(upperMotorOutPut[3][0]) < 0.01f ? 0.0f : upperMotorOutPut[3][0];

        //水平电机推力分配
        yawFbLrControllerOutput[0][0] = yawOutput;
        yawFbLrControllerOutput[1][0] = targetVel[0][0];
        yawFbLrControllerOutput[2][0] = targetVel[1][0];

        Matrixf<4,1> lowerMotorOutPut = B * yawFbLrControllerOutput;
        lowerMotorOutPut[0][0] = fabsf(lowerMotorOutPut[0][0]) < 0.01f ? 0.0f : lowerMotorOutPut[0][0];
        lowerMotorOutPut[1][0] = fabsf(lowerMotorOutPut[1][0]) < 0.01f ? 0.0f : lowerMotorOutPut[1][0];
        lowerMotorOutPut[2][0] = fabsf(lowerMotorOutPut[2][0]) < 0.01f ? 0.0f : lowerMotorOutPut[2][0];
        lowerMotorOutPut[3][0] = fabsf(lowerMotorOutPut[3][0]) < 0.01f ? 0.0f : lowerMotorOutPut[3][0];

        motors[1].motor->SetThrottle(upperMotorOutPut[0][0]);
        motors[2].motor->SetThrottle(upperMotorOutPut[1][0]);
        motors[5].motor->SetThrottle(upperMotorOutPut[2][0]);
        motors[6].motor->SetThrottle(upperMotorOutPut[3][0]);

        motors[0].motor->SetThrottle(lowerMotorOutPut[0][0]);
        motors[3].motor->SetThrottle(lowerMotorOutPut[1][0]);
        motors[4].motor->SetThrottle(lowerMotorOutPut[2][0]);
        motors[7].motor->SetThrottle(lowerMotorOutPut[3][0]);
    }

    /*** 水平姿态保持模式 ***/
    void StabilizeMode() {
    }

    /*** 全向姿态保持模式 ***/
    void PositionHoldMode() {
    }

    void SwitchState(uint8_t buttonState) {
        static uint8_t lastButtonState = 0;
        if(buttonState != lastButtonState &&  buttonState == 1) {
            if(state == SUB_STATE::IDLE) {
                EnableMotors();
                targetAttitude[2][0] = currentAttitude[2][0];
                state = SUB_STATE::STABILIZING;
            }
            else if(state == SUB_STATE::STABILIZING) {
                DisableMotors();
                state = SUB_STATE::IDLE;
            }
        }
        lastButtonState = buttonState;
    }
};


V5_SUB* V5_SUBBuilder::Build() {
    return new V5_SUB(*this);
}

#endif //V5_SUB_HPP
