IWIN-FINS/FinsROV-Heavy/firmware/inertial-odometry/Interface/Examples/TaskPOVChassis.cpp

/*******************************************************************************
 * Copyright (c) 2025.
 * IWIN-FINS Lab, Shanghai Jiao Tong University, Shanghai, China.
 * All rights reserved.
 ******************************************************************************/

#include "ProjectConfig.h"

#ifdef __Keil_APP
#ifndef WITH_POV_EXAMPLE
#define WITH_POV_EXAMPLE
#endif
#endif

#ifdef WITH_POV_EXAMPLE


#include "Task.h"

/**
* Part 1 (Case 1): Motor definitions.
*/

#include "ServoMotors/Motor4010.hpp"
#include "ServoMotors/Motor4315.hpp"

#include "Control/PID.hpp"

constexpr PID_Param_t speedPID = {0.23f, 0.008f, 0.3f, 2000, 2000};

auto wheelControllers = CreateControllers<PID, 4>(speedPID);
auto swerveControllers = CreateControllers<Amplifier<1>, 4>();

#define TORQUE_2_SPEED {Motor_Ctrl_Type_e::Torque, Motor_Ctrl_Type_e::Speed}
Motor4010<1> CBRMotor(TORQUE_2_SPEED, wheelControllers[0], 0x144);
Motor4010<1> CBLMotor(TORQUE_2_SPEED, wheelControllers[1], 0x143);
Motor4010<1> CFLMotor(TORQUE_2_SPEED, wheelControllers[2], 0x142);
Motor4010<1> CFRMotor(TORQUE_2_SPEED, wheelControllers[3], 0x141);

#define DIRECT_POSITION {Motor_Ctrl_Type_e::Position, Motor_Ctrl_Type_e::Position, true}
Motor4315<1> SBRMotor(DIRECT_POSITION, swerveControllers[0], 0x04);
Motor4315<1> SBLMotor(DIRECT_POSITION, swerveControllers[1], 0x03);
Motor4315<1> SFLMotor(DIRECT_POSITION, swerveControllers[2], 0x02);
Motor4315<1> SFRMotor(DIRECT_POSITION, swerveControllers[3], 0x01);





/**
* Part 1 (Case 2): Motor definitions.
*/

// #include "ServoMotors/RMD_L_40xx_v3.hpp"
//
// #include "Control/PID.hpp"
//
// constexpr PID_Param_t speedPID = {0.15f, 0.00145f, 0.0016f, 8000, 500};
// constexpr PID_Param_t positionInnerPID = {0.5f, 0.0f, 0.02f, 500, 500};
// constexpr PID_Param_t potisionOuterPID = {35.0f, 0.15f, 0.01f, 800, 800};
//
// auto wheelControllers = CreateControllers<PID, 4>(speedPID);
// auto swerveControllers = CreateControllers<CascadePID, 4>(potisionOuterPID, positionInnerPID);
//
// #define TORQUE_2_SPEED {Motor_Ctrl_Type_e::Torque, Motor_Ctrl_Type_e::Speed}
// #define TORQUE_2_POSITION {Motor_Ctrl_Type_e::Torque, Motor_Ctrl_Type_e::Position, true}
//
// RMD_L_40xx_v3<1> CFRMotor(TORQUE_2_SPEED, wheelControllers[0], 0x242);
// RMD_L_40xx_v3<1> CFLMotor(TORQUE_2_SPEED, wheelControllers[1], 0x244);
// RMD_L_40xx_v3<1> CBLMotor(TORQUE_2_SPEED, wheelControllers[2], 0x246);
// RMD_L_40xx_v3<1> CBRMotor(TORQUE_2_SPEED, wheelControllers[3], 0x248);
//
// RMD_L_40xx_v3<1> SFRMotor(TORQUE_2_POSITION, swerveControllers[0], 0x241);
// RMD_L_40xx_v3<1> SFLMotor(TORQUE_2_POSITION, swerveControllers[1], 0x243);
// RMD_L_40xx_v3<1> SBLMotor(TORQUE_2_POSITION, swerveControllers[2], 0x245);
// RMD_L_40xx_v3<1> SBRMotor(TORQUE_2_POSITION, swerveControllers[3], 0x247);





/**
* Part 2: Chassis definitions.
*/

#include "Chassis/POV_Chassis.hpp"

constexpr float ROBOT_LENGTH = 0.240225f;
constexpr float ROBOT_WIDTH = 0.24f;
constexpr float WHEEL_DIAMETER = 0.0483;

auto chassis = POV_ChassisBuilder<PlanarOdom>( \
    WHEEL_DIAMETER, \
    Swerve_t{&SFRMotor, &CFRMotor,  ROBOT_LENGTH / 2, -ROBOT_WIDTH / 2, 180},
    Swerve_t{&SFLMotor, &CFLMotor,  ROBOT_LENGTH / 2,  ROBOT_WIDTH / 2},
    Swerve_t{&SBLMotor, &CBLMotor, -ROBOT_LENGTH / 2,  ROBOT_WIDTH / 2},
    Swerve_t{&SBRMotor, &CBRMotor, -ROBOT_LENGTH / 2, -ROBOT_WIDTH / 2, 180}
    );





/**
* Part 3: Command input definitions.
*/

#include "RemoteControllers/RadioMaster_Zorro.h"
#include "FineWarden/FineSerial.hpp"

FineSerial fineSerial;
UARTBuffer<5, 200> uart5Buffer([](uint8_t* data, size_t length) {
    fineSerial.Decode(data, length);
});

RadioMaster_Zorro remote;
UARTBuffer<3, 200> uart3Buffer([](uint8_t* data, size_t length) {
    remote.Decode(data, length);
});





/**
* Part 4: Task definitions.
*/

void TaskPOVChassis() {
    constexpr float SPEED_LIMIT = 2.0f;

     if(remote.GetInfo().sC == RemoteControl::SWITCH_STATE_E::UP_POS) {
         std::array<float, 3> targetV = {
             remote.GetInfo().rightCol * SPEED_LIMIT,
             -remote.GetInfo().rightRol * SPEED_LIMIT,
             -remote.GetInfo().leftRol * PI };
     chassis.SetVelocity(std::move(targetV));
     }
     if(remote.GetInfo().sC == RemoteControl::SWITCH_STATE_E::DOWN_POS) {
        chassis.SetVelocity(fineSerial.GetVelCmd());
     }
}
TASK_EXPORT(TaskPOVChassis);

#endif
