IWIN-FINS/FinsROV-Heavy/(commit log)

2026-11-10 Publish LM5069 power board fabrication files
2026-11-11 Publish SUB and inertial odometry firmware snapshots
2026-11-11 Publish mechanical models and fabrication guide with BOM mapping
2026-11-11 Add illustrated V5 build tutorials and Jetson host setup
