IWIN-FINS/FinsROV-Heavy/docs/assets/frame/image_05.png

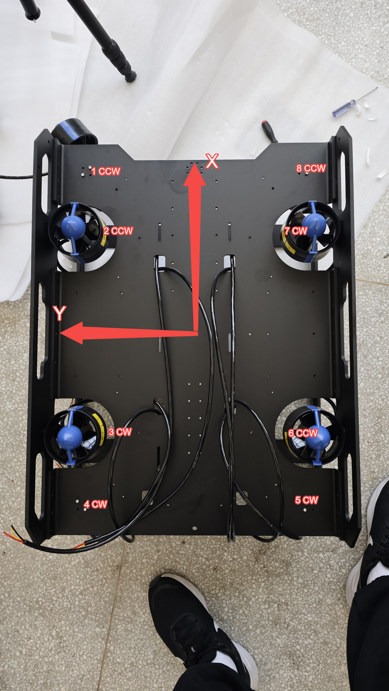
[picture p50: docs/assets/frame/image_05.png]
docs/assets/frame/image_05.png
